joymonkey/logicengine/docs/img/Reactor-Zero-V6-overview.jpg

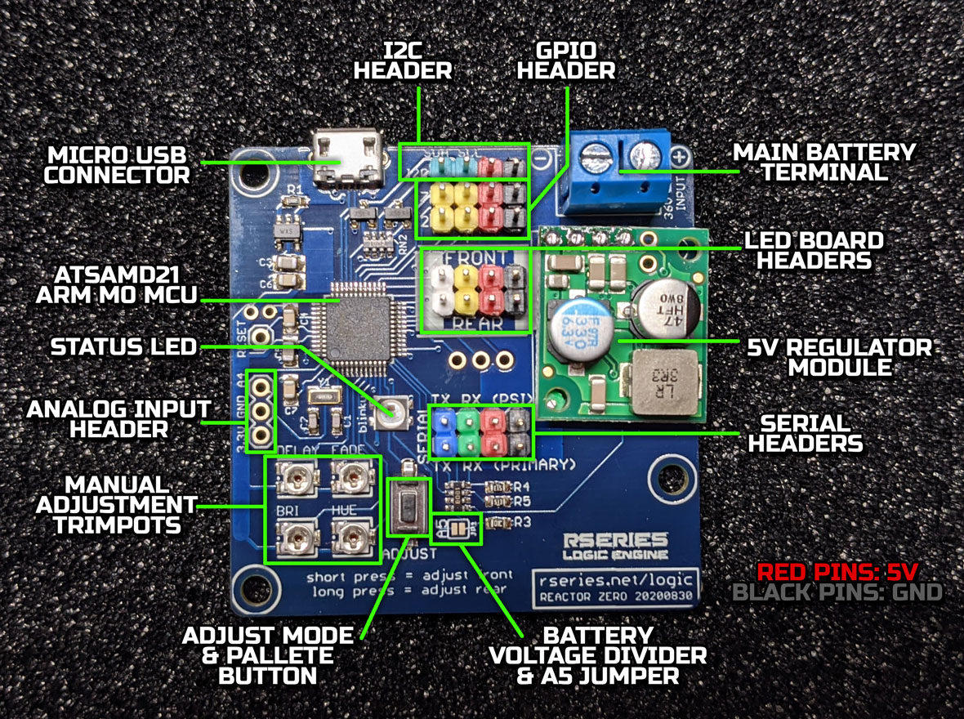
docs/img/Reactor-Zero-V6-overview.jpg
