joymonkey/logicengine/docs/img/Reactor-Zero-New-Pins.jpg

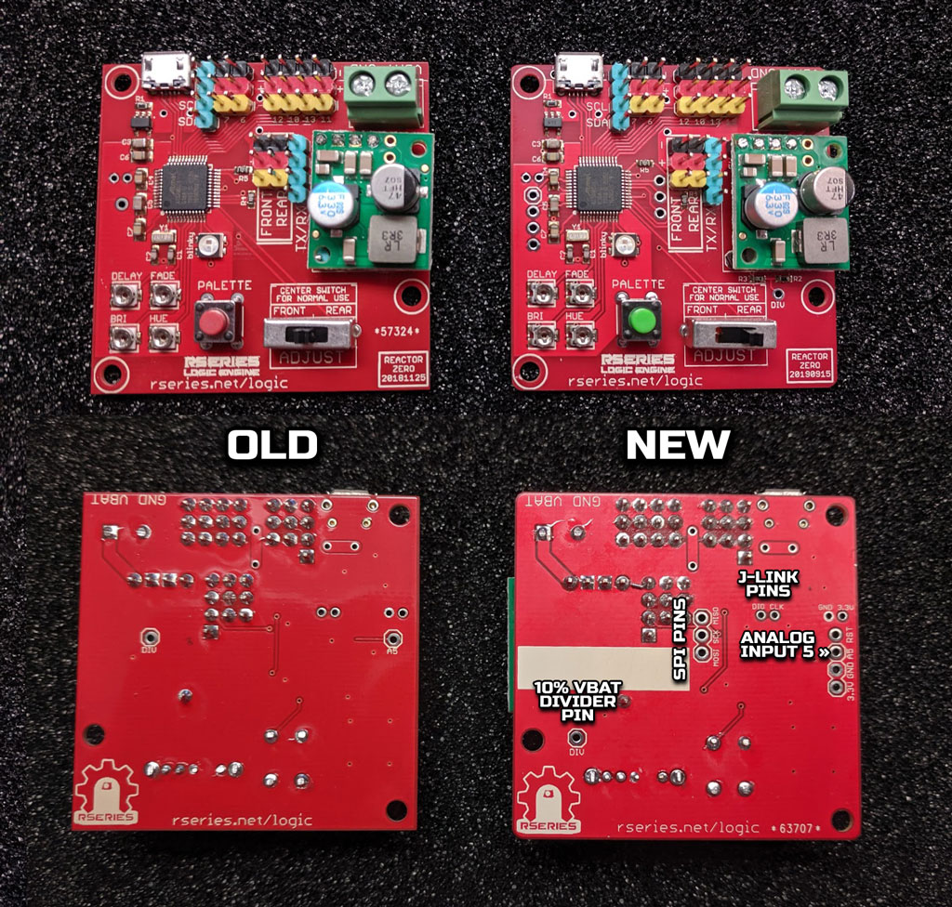
docs/img/Reactor-Zero-New-Pins.jpg
