joymonkey/logicengine/README.md

# logicengine
Info, Hardware Files and Arduino Sketches for the RSeries Logic Engine.

Assembly instructions and documentation can be found in the GitHub wiki here...
https://github.com/joymonkey/logicengine/wiki
