joymonkey/logicengine/docs/img/2016front1.jpg

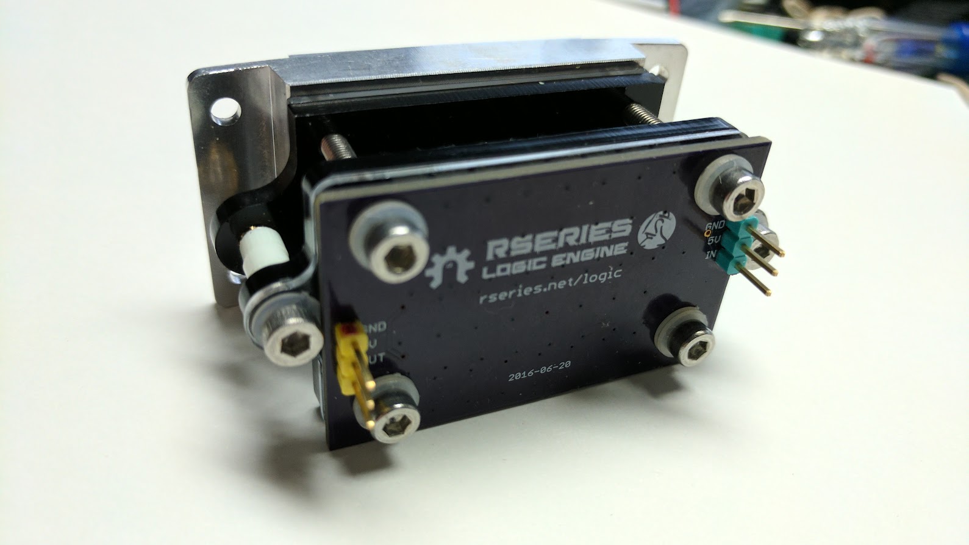
docs/img/2016front1.jpg
