joymonkey/logicengine/docs/img/2016front2.jpg

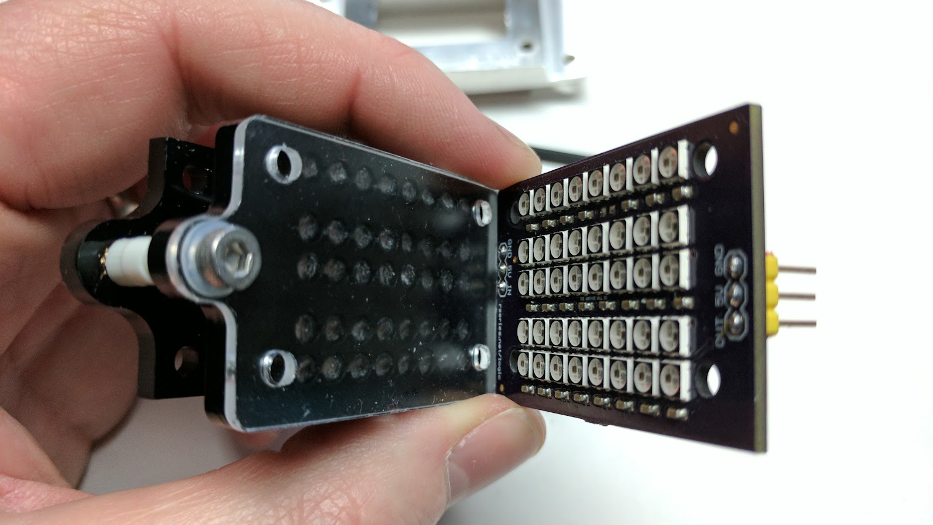
docs/img/2016front2.jpg
