joymonkey/logicengine/docs/img/avr_ftdi.png

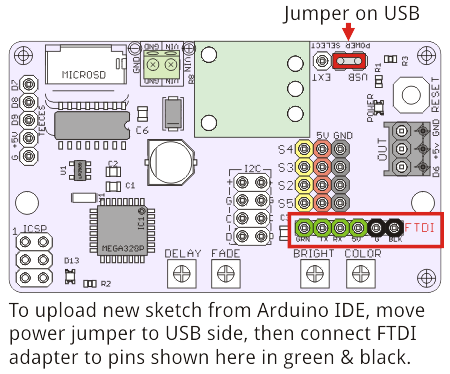
docs/img/avr_ftdi.png
