joymonkey/logicengine/docs/img/avr_microsd.png

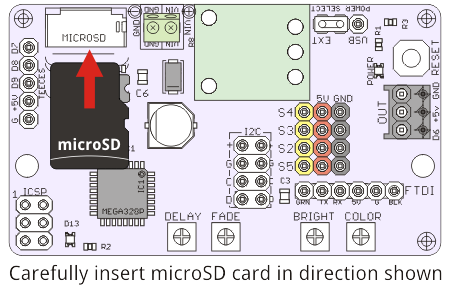
docs/img/avr_microsd.png
