joymonkey/logicengine/docs/img/avr_mode.png

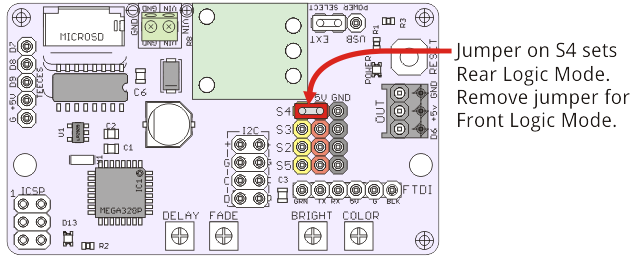
docs/img/avr_mode.png
