joymonkey/logicengine/docs/img/avr_powering.png

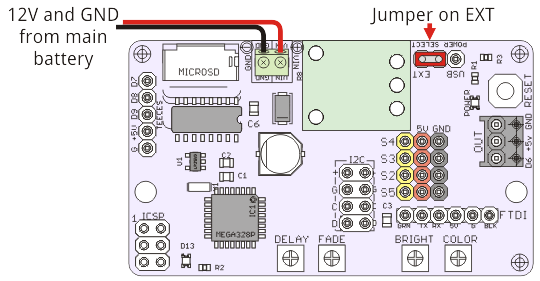
docs/img/avr_powering.png
