joymonkey/logicengine/docs/img/avr_speed.png

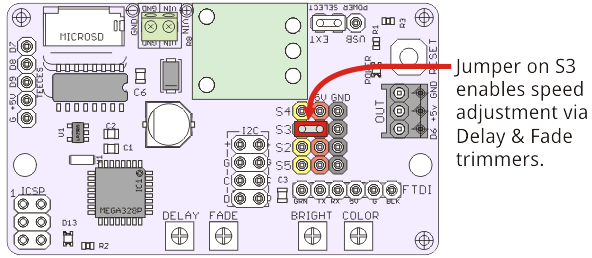
docs/img/avr_speed.png
