joymonkey/logicengine/docs/img/avr_to_teeces_psi.png

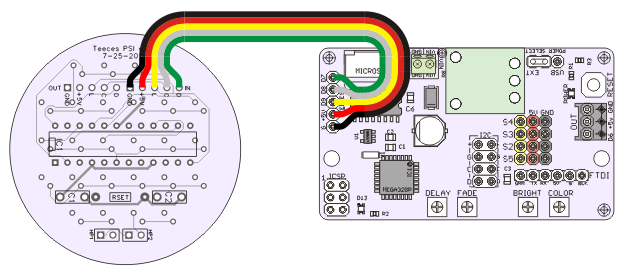
docs/img/avr_to_teeces_psi.png
