joymonkey/logicengine/docs/img/Deathstar1.jpg

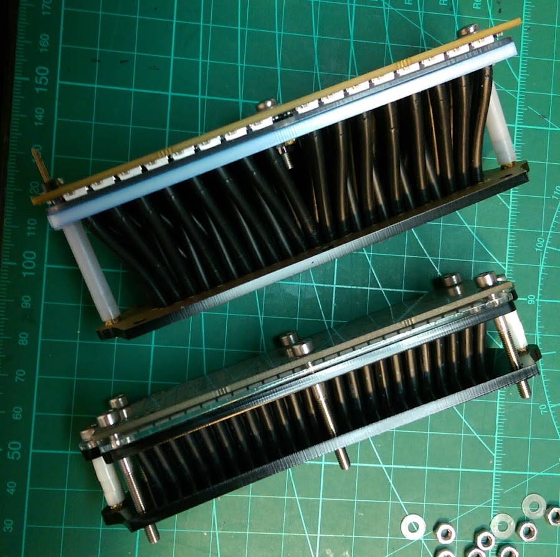
docs/img/Deathstar1.jpg
