joymonkey/logicengine/docs/img/Deathstar2.jpg

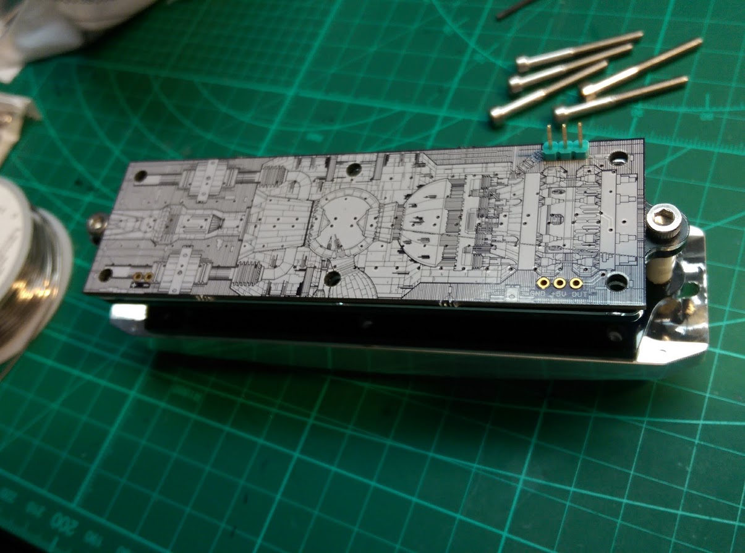
docs/img/Deathstar2.jpg
