joymonkey/logicengine/docs/img/Deathstar3.jpg

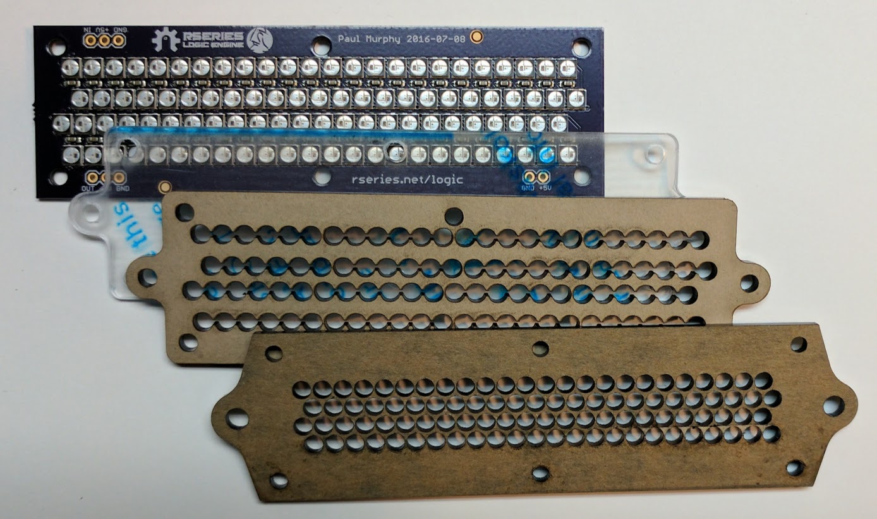
docs/img/Deathstar3.jpg
