joymonkey/logicengine/docs/img/front_bez_orientation1.jpg

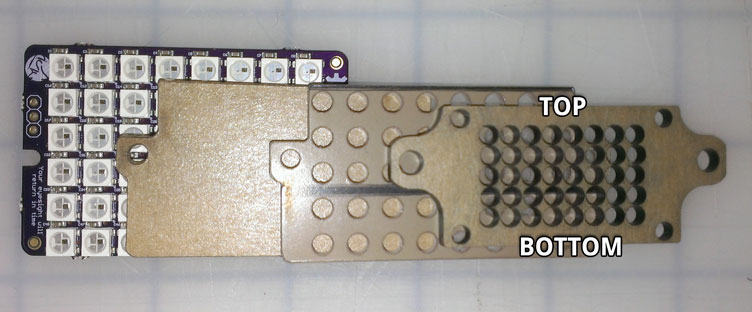
docs/img/front_bez_orientation1.jpg
