joymonkey/logicengine/docs/img/front_bez_orientation2.jpg

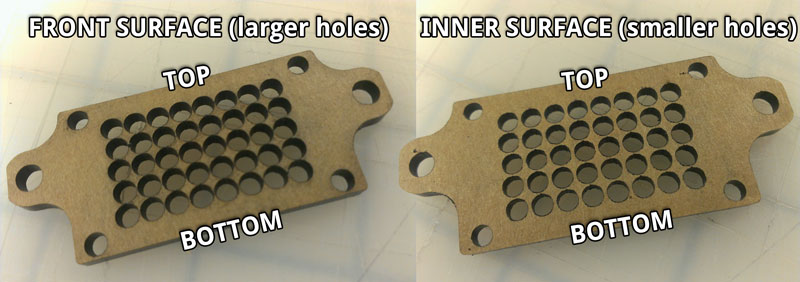
docs/img/front_bez_orientation2.jpg
