joymonkey/logicengine/docs/img/ImaharaRLD1.jpg

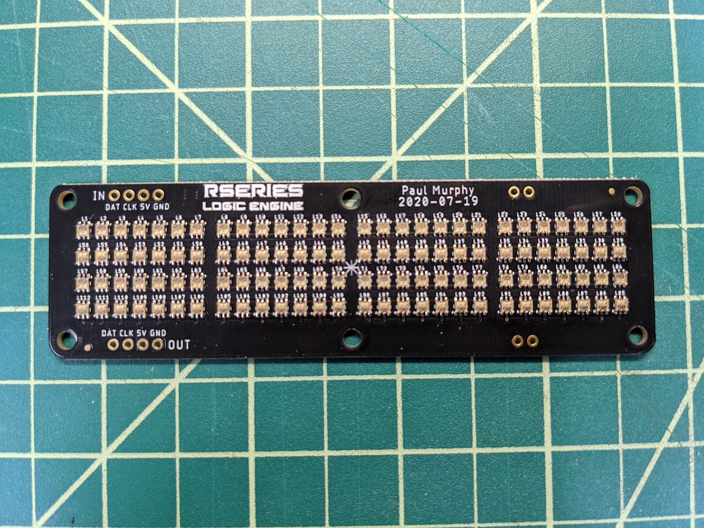
docs/img/ImaharaRLD1.jpg
