joymonkey/logicengine/docs/img/ImaharaRLD2.jpg

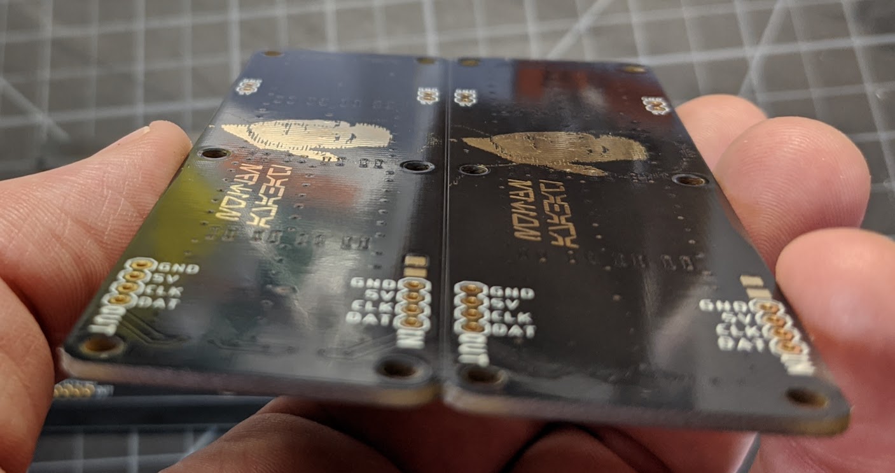
docs/img/ImaharaRLD2.jpg
