joymonkey/logicengine/docs/img/ImaharaRLD3.jpg

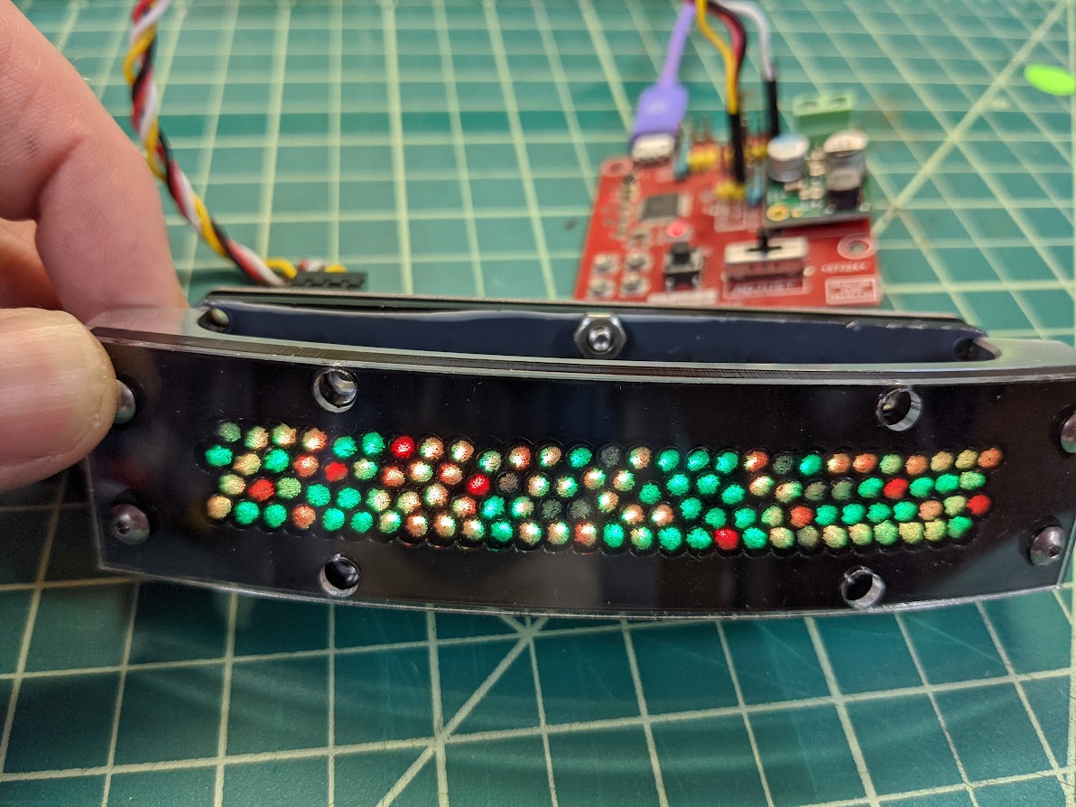
docs/img/ImaharaRLD3.jpg
