joymonkey/logicengine/docs/img/Logic-Engine-LED-board-front.png

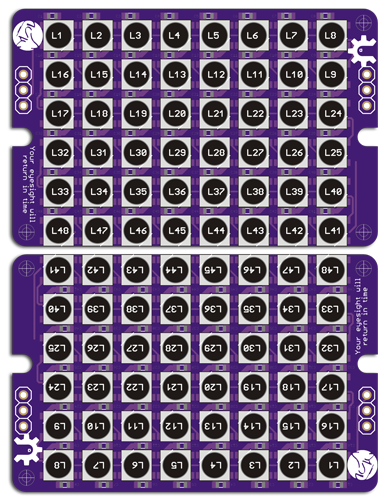
docs/img/Logic-Engine-LED-board-front.png
