joymonkey/logicengine/docs/img/Logic-Engine-LED-board-rear.png

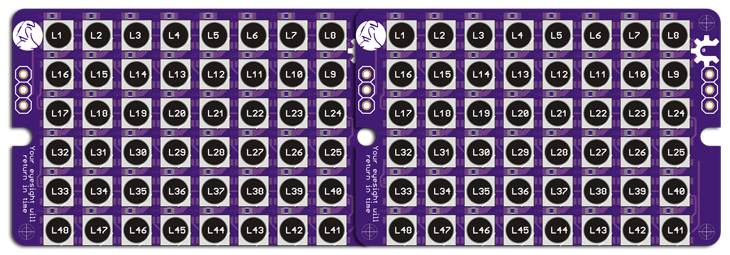
docs/img/Logic-Engine-LED-board-rear.png
