joymonkey/logicengine/docs/img/Logic_Engine_V6_cheat_sheet.png

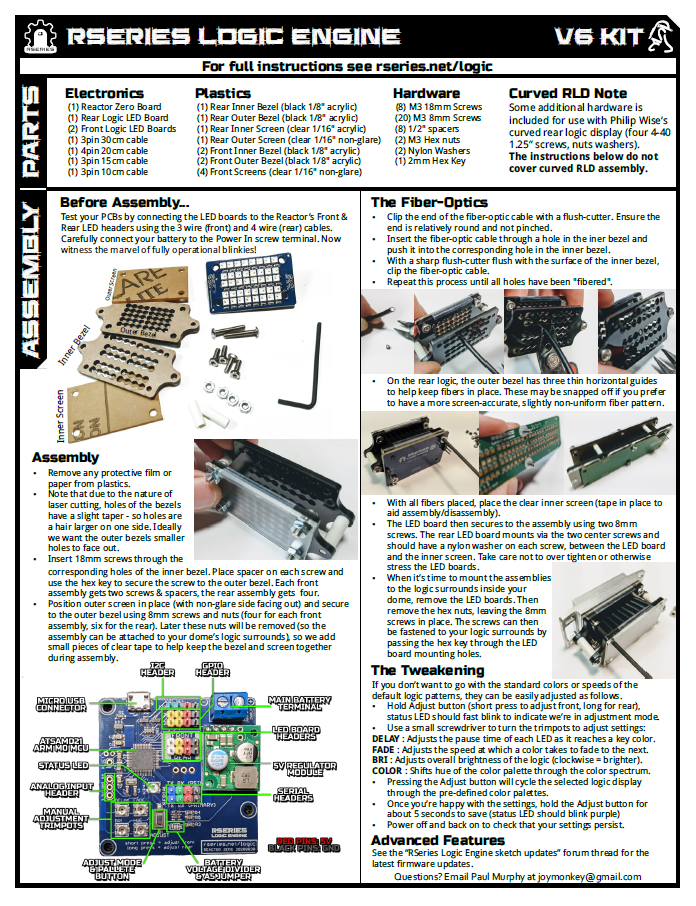
docs/img/Logic_Engine_V6_cheat_sheet.png
