joymonkey/logicengine/docs/img/LogicEngineAVRBoard.png

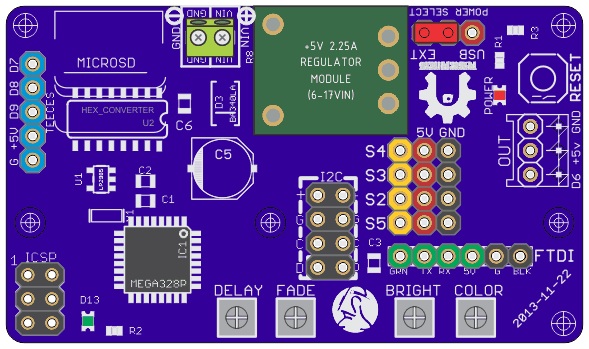
docs/img/LogicEngineAVRBoard.png
