joymonkey/logicengine/docs/img/LogicEngineDMX.jpg

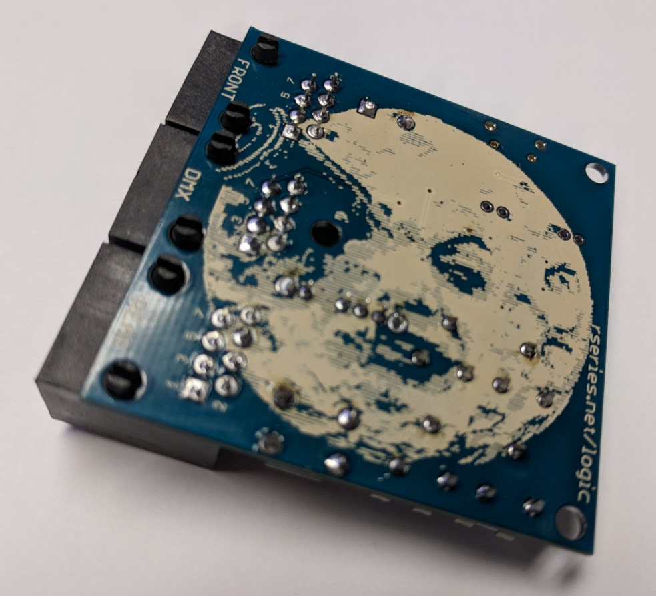
docs/img/LogicEngineDMX.jpg
