joymonkey/logicengine/docs/img/LogicEngineDMX_2.jpg

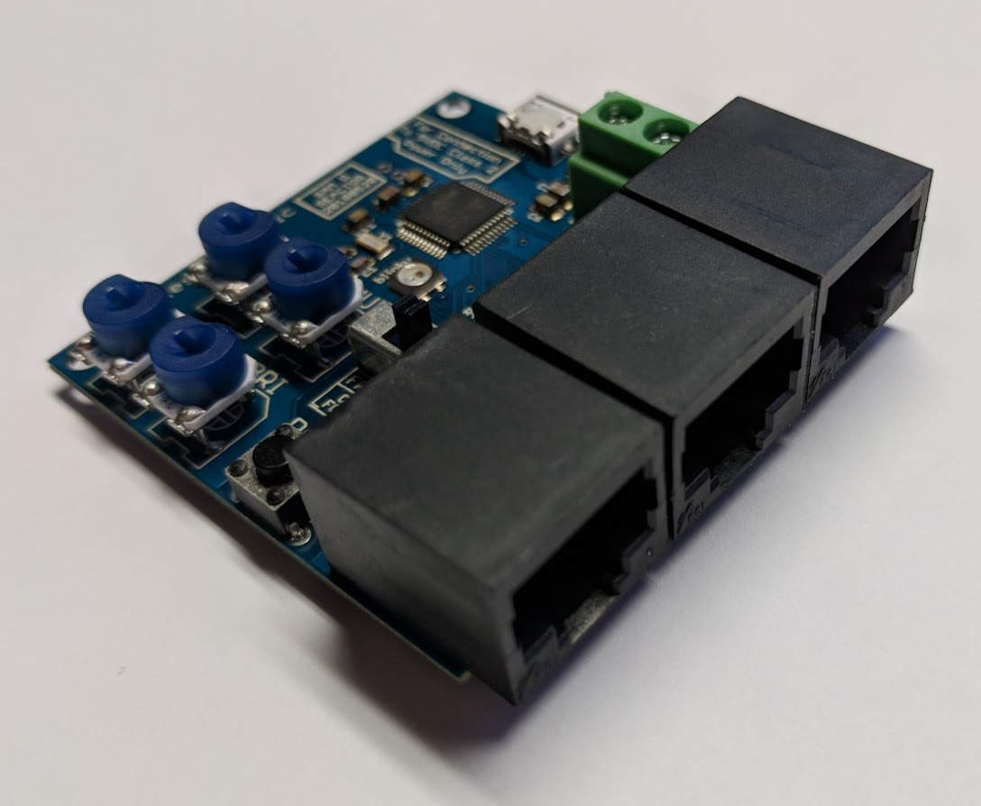
docs/img/LogicEngineDMX_2.jpg
