joymonkey/logicengine/docs/img/LogicEngineDMX_3.jpg

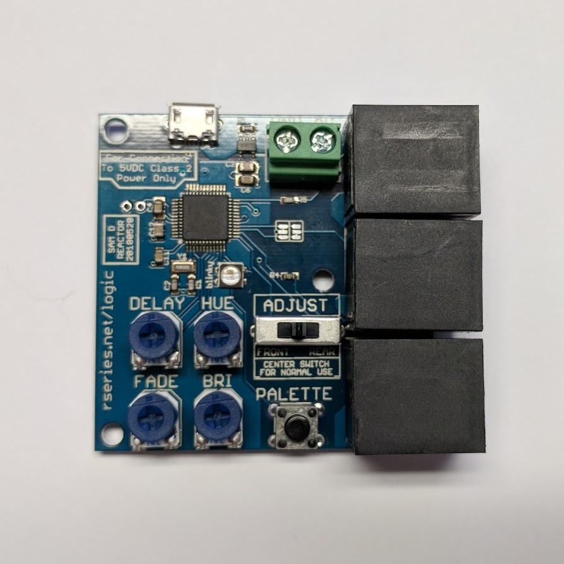
docs/img/LogicEngineDMX_3.jpg
