joymonkey/logicengine/docs/img/LogicEngineDMX_4.jpg

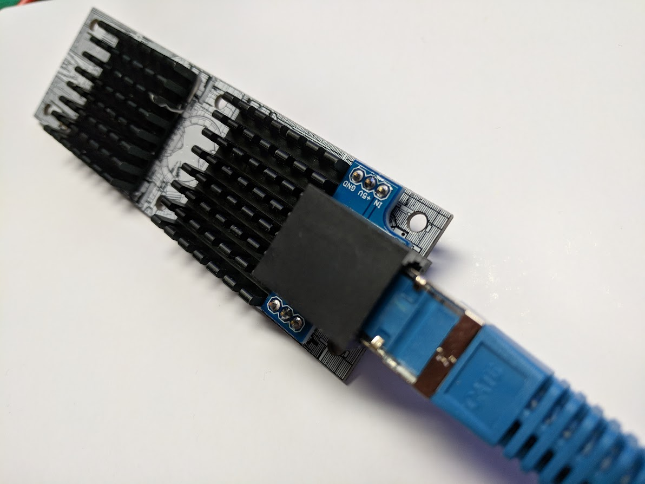
docs/img/LogicEngineDMX_4.jpg
