joymonkey/logicengine/docs/img/Reactor Zero to Teeces PSI Hookup.s.png

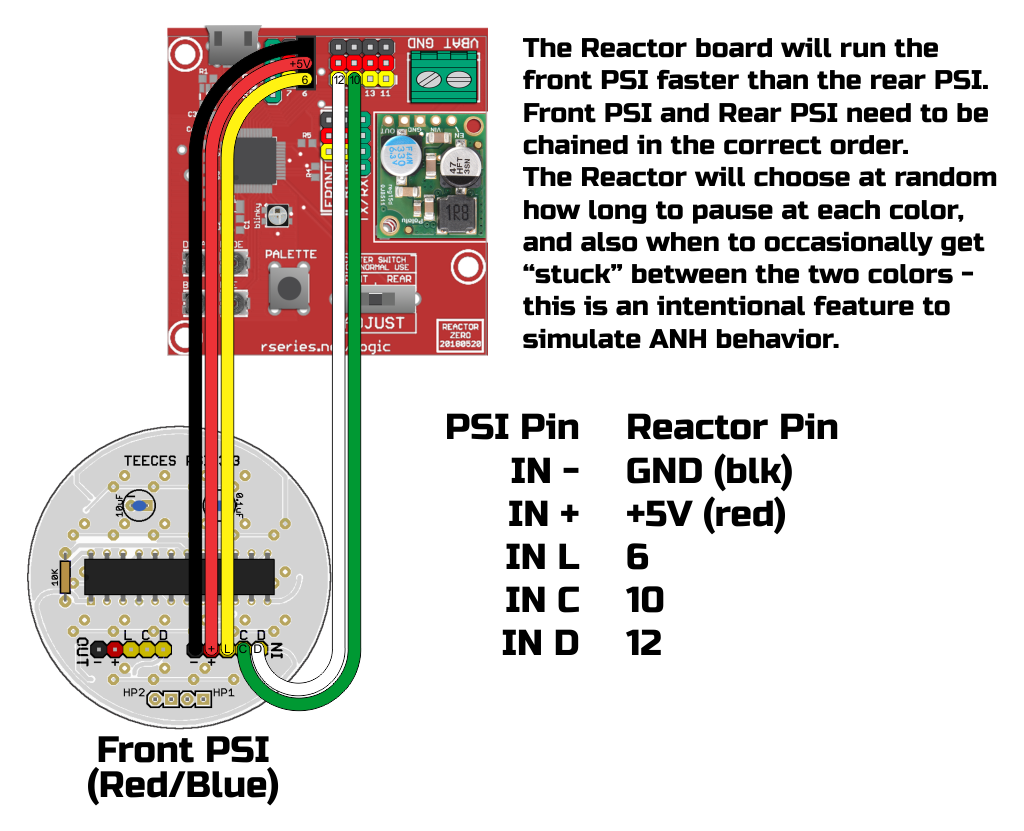
docs/img/Reactor Zero to Teeces PSI Hookup.s.png
