joymonkey/logicengine/docs/img/Reactor-Zero-20181125.jpg

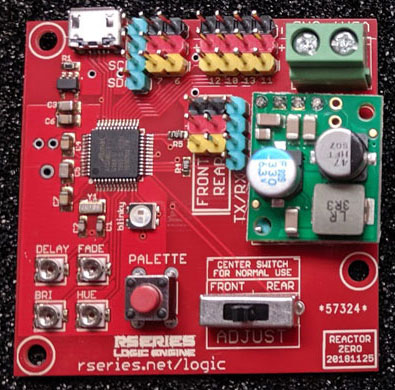
docs/img/Reactor-Zero-20181125.jpg
