joymonkey/logicengine/docs/img/Reactor-Zero-20190915.jpg

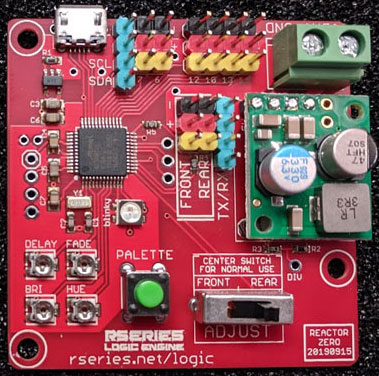
docs/img/Reactor-Zero-20190915.jpg
