joymonkey/logicengine/docs/img/Reactor-Zero-20200830.jpg

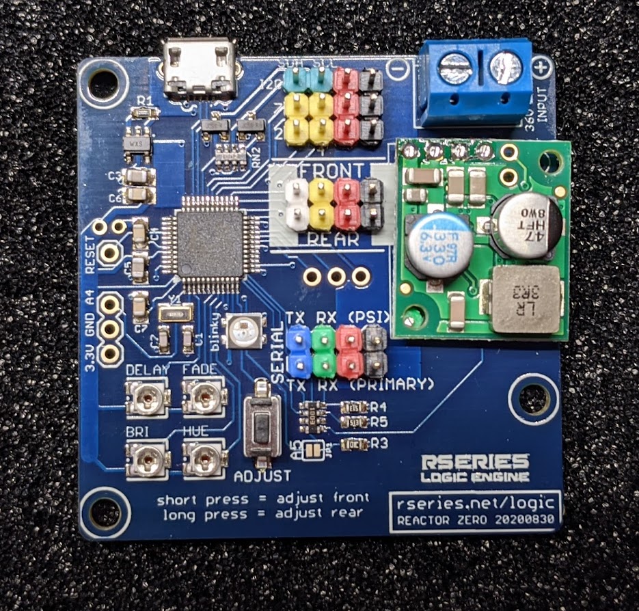
docs/img/Reactor-Zero-20200830.jpg
