joymonkey/logicengine/docs/img/Reactor-Zero-SerialAdapter.jpg

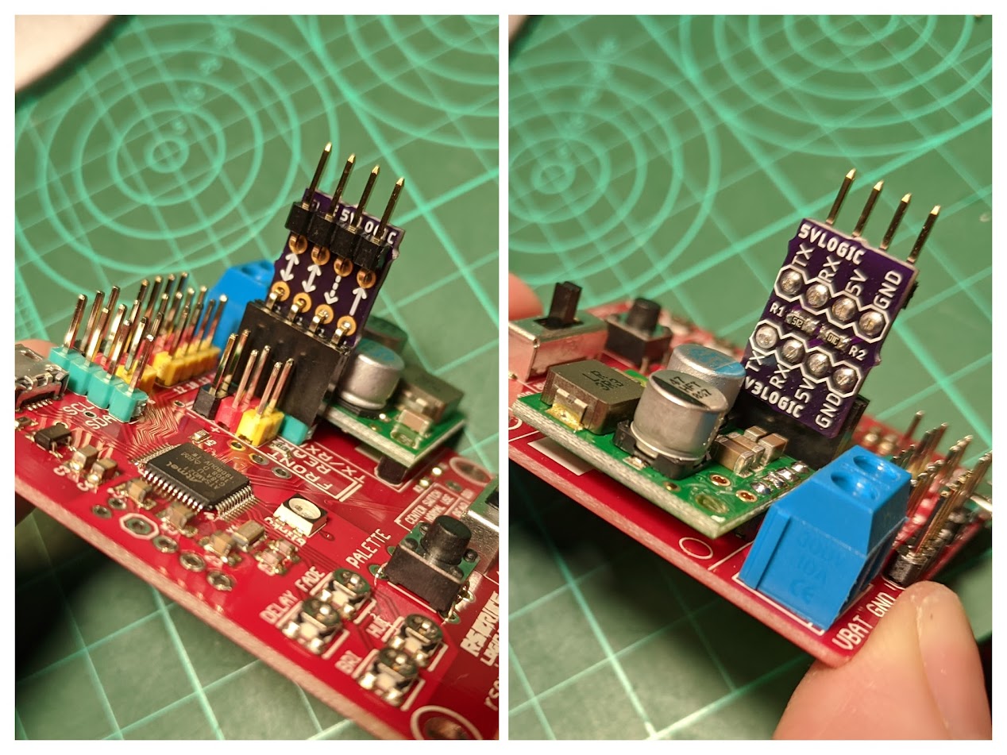
docs/img/Reactor-Zero-SerialAdapter.jpg
