joymonkey/logicengine/docs/img/ReactorZero-board-only.png

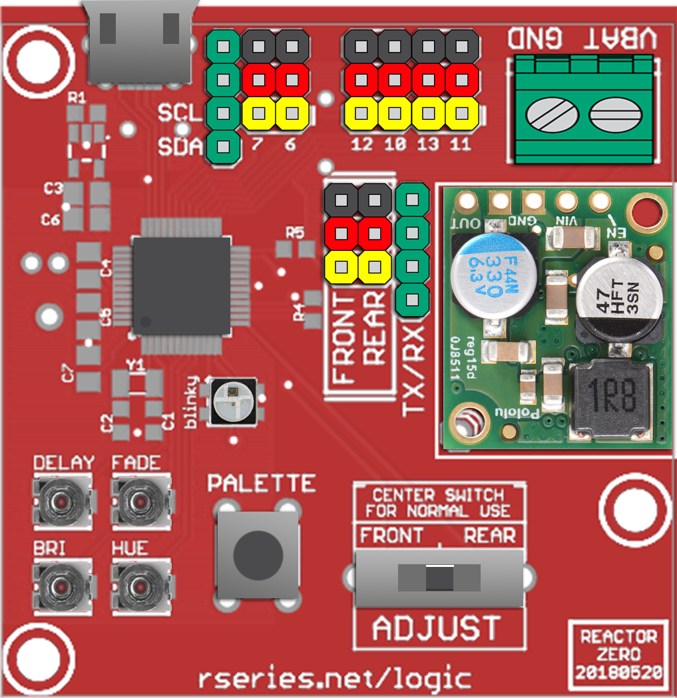
docs/img/ReactorZero-board-only.png
