joymonkey/logicengine/docs/img/rld-pattern-numbered.png

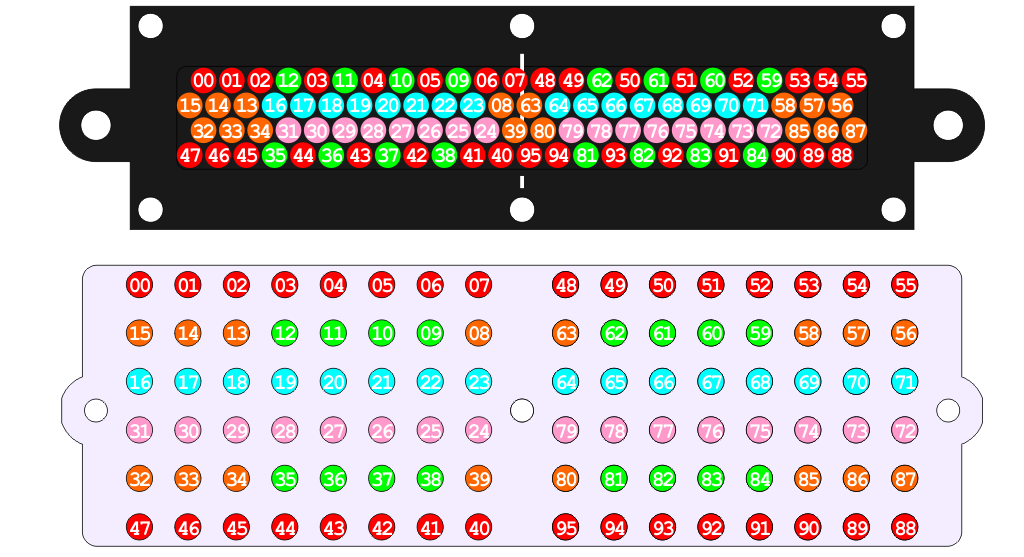
docs/img/rld-pattern-numbered.png
