joymonkey/logicengine/docs/img/TeensyReactor_full.jpg

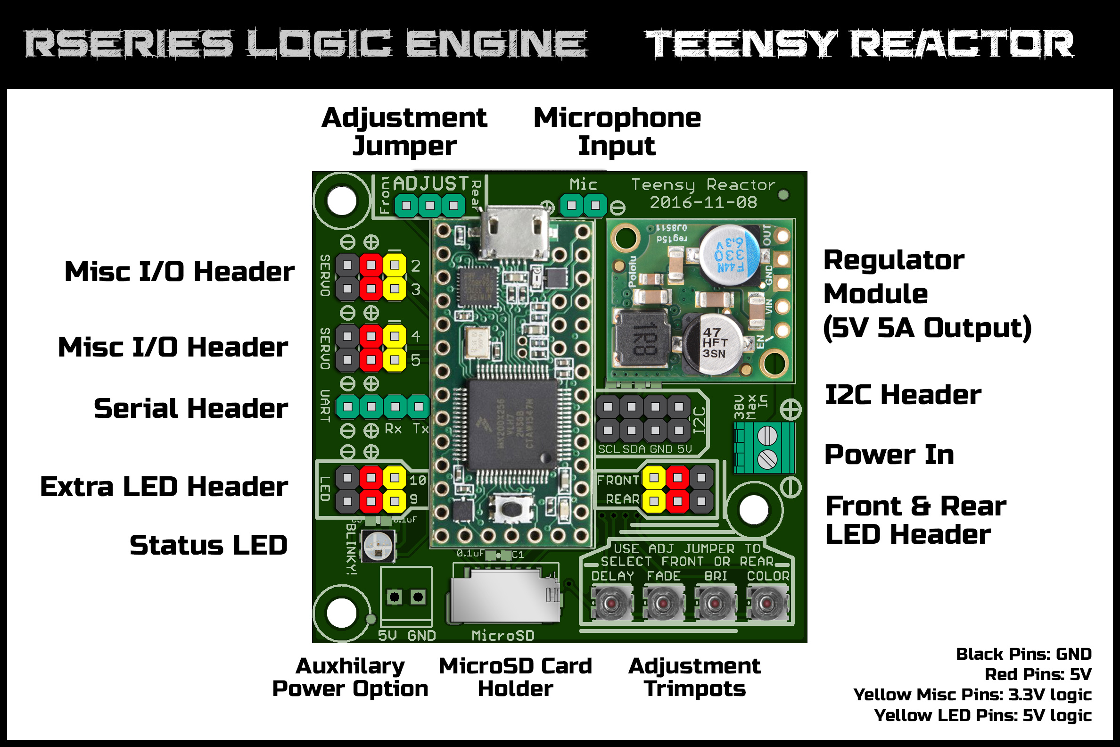
docs/img/TeensyReactor_full.jpg
