joymonkey/logicengine/docs/img/TeensyReactorPrototype.jpg

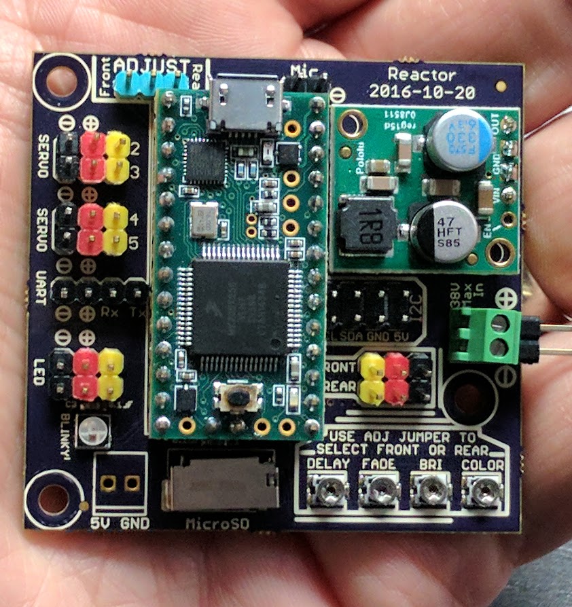
docs/img/TeensyReactorPrototype.jpg
