joymonkey/logicengine/docs/img/uploadZeroFW/3-select_Board.png

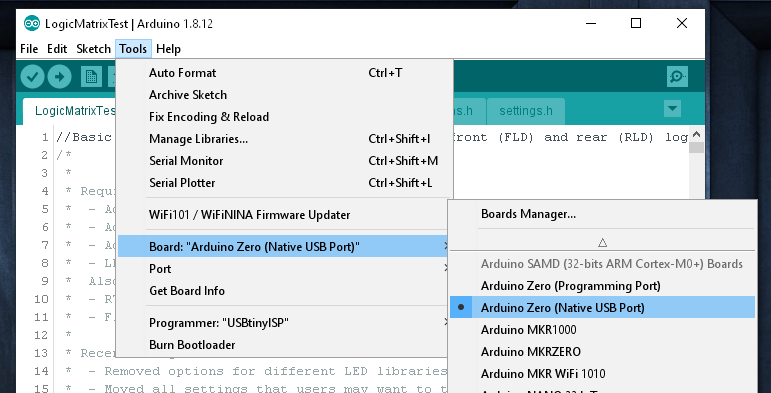
docs/img/uploadZeroFW/3-select_Board.png
