joymonkey/logicengine/docs/img/uploadZeroFW/4-select_Port.png

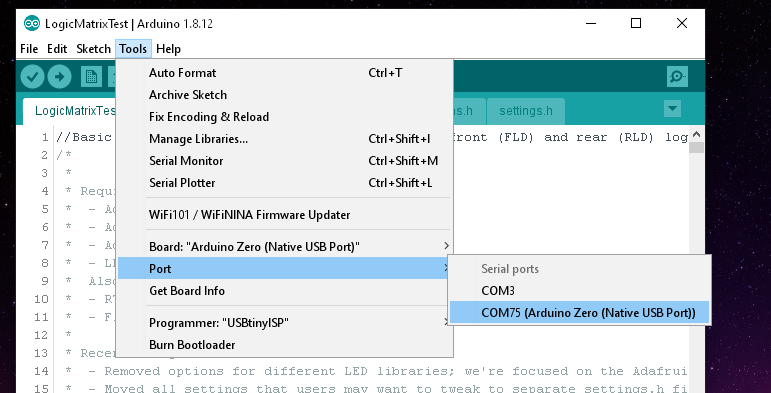
docs/img/uploadZeroFW/4-select_Port.png
