joymonkey/logicengine/docs/img/uploadZeroFW/5-upload_Success.png

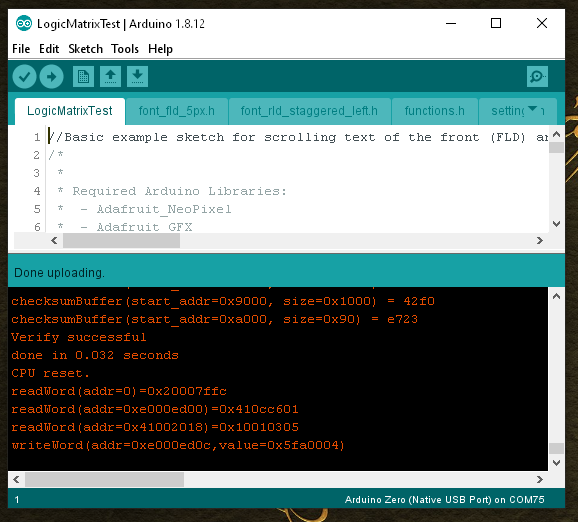
docs/img/uploadZeroFW/5-upload_Success.png
