joymonkey/logicengine/docs/img/WREACTOR32-PCB.png

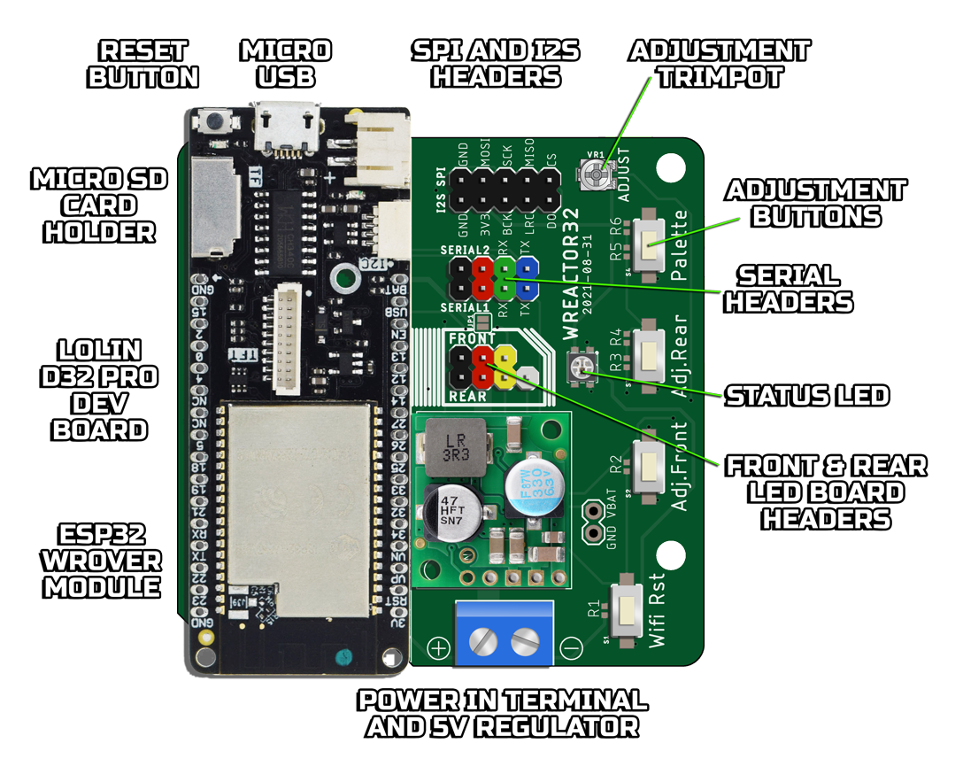
docs/img/WREACTOR32-PCB.png
