joymonkey/logicengine/docs/img/wreactor32/1-home.png

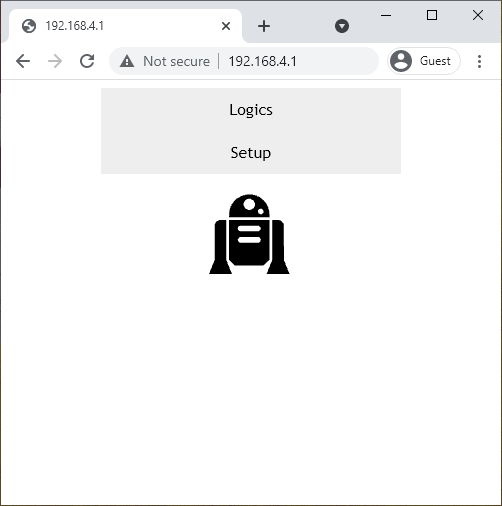
docs/img/wreactor32/1-home.png
