joymonkey/logicengine/docs/img/wreactor32/1-home_th.png

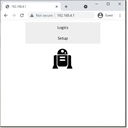
docs/img/wreactor32/1-home_th.png
