joymonkey/logicengine/docs/img/wreactor32/2-logics.png

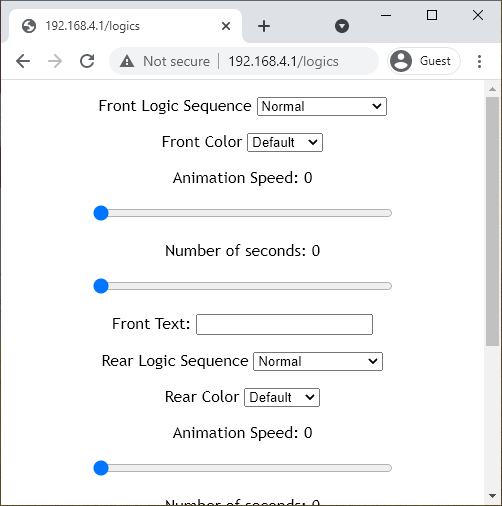
docs/img/wreactor32/2-logics.png
