joymonkey/logicengine/docs/img/wreactor32/4-firmware.png

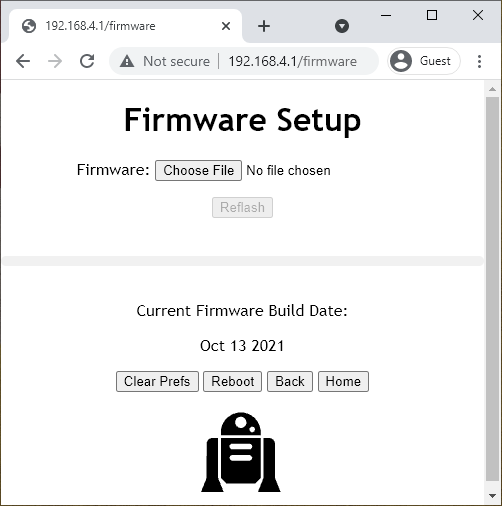
docs/img/wreactor32/4-firmware.png
