joymonkey/logicengine/docs/img/wreactor32/5-marcduino.png

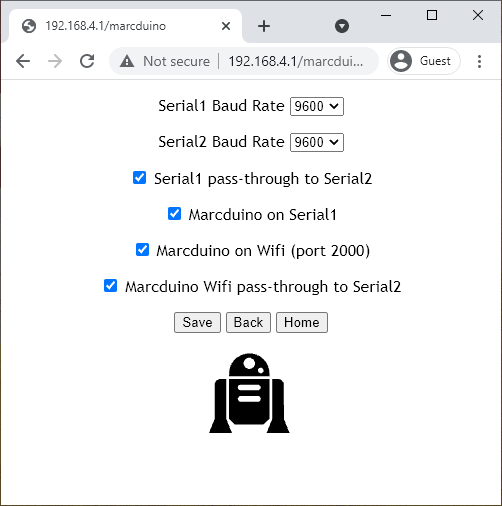
docs/img/wreactor32/5-marcduino.png
