joymonkey/logicengine/docs/img/wreactor32/5-marcduino_th.png

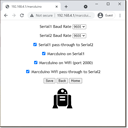
docs/img/wreactor32/5-marcduino_th.png
