joymonkey/logicengine/docs/img/wreactor32/6-wifi.png

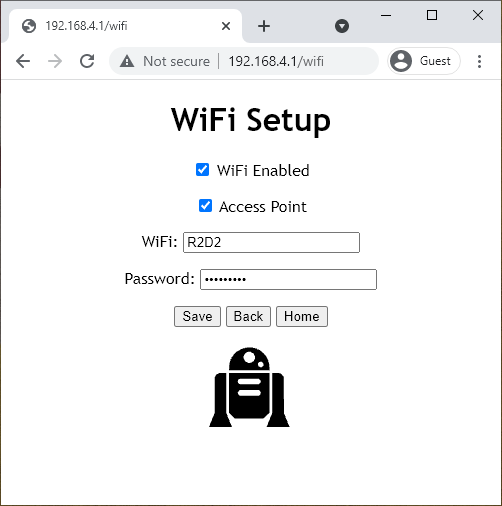
docs/img/wreactor32/6-wifi.png
