joymonkey/logicengine/docs/img/WReactor32_2024.jpg

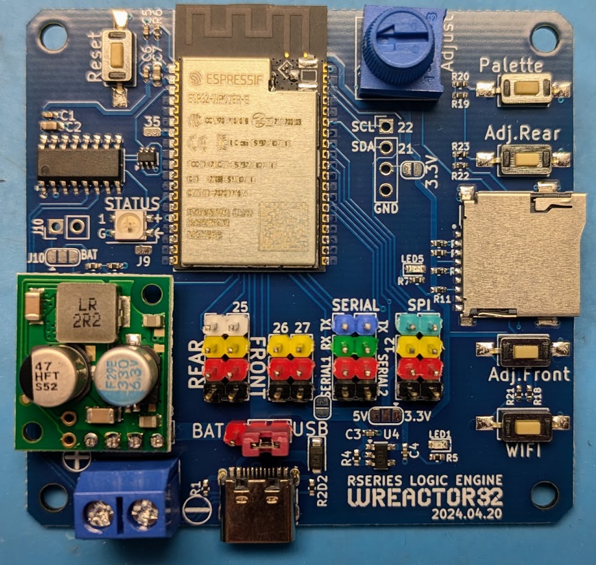
docs/img/WReactor32_2024.jpg
