joymonkey/logicengine/wreactor32_rework/rework1.jpg

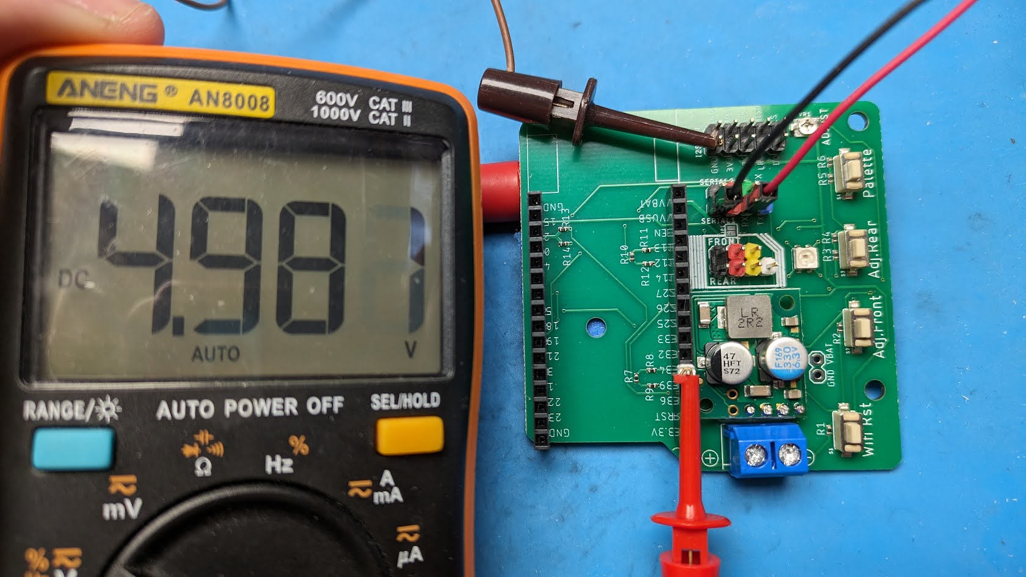
wreactor32_rework/rework1.jpg
