joymonkey/logicengine/wreactor32_rework/rework2.jpg

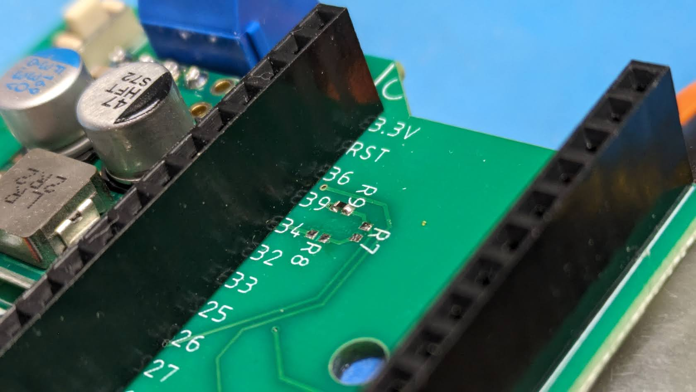
wreactor32_rework/rework2.jpg
