joymonkey/logicengine/wreactor32_rework/rework3.jpg

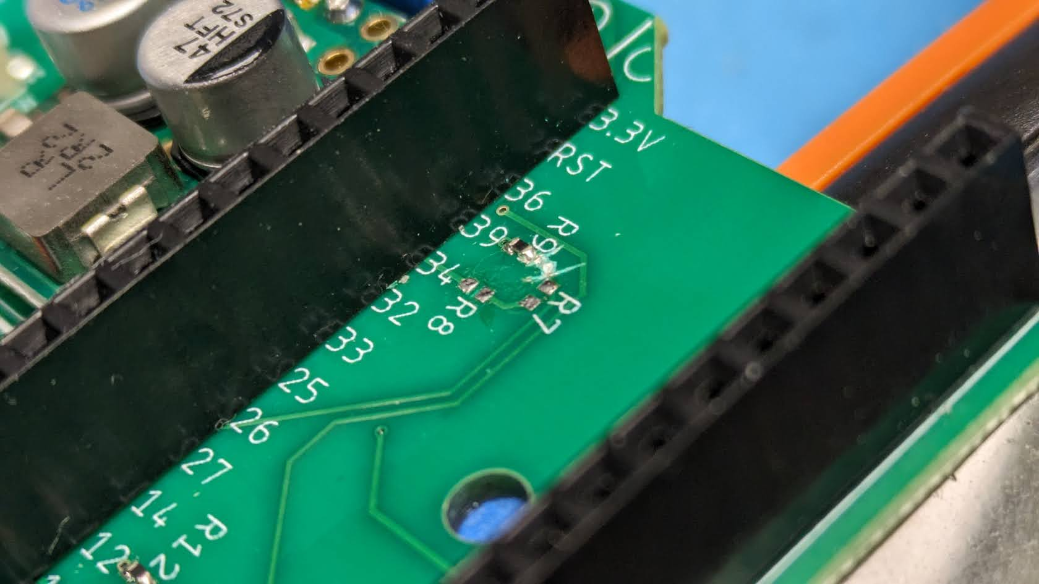
wreactor32_rework/rework3.jpg
