joymonkey/logicengine/wreactor32_rework/rework4.jpg

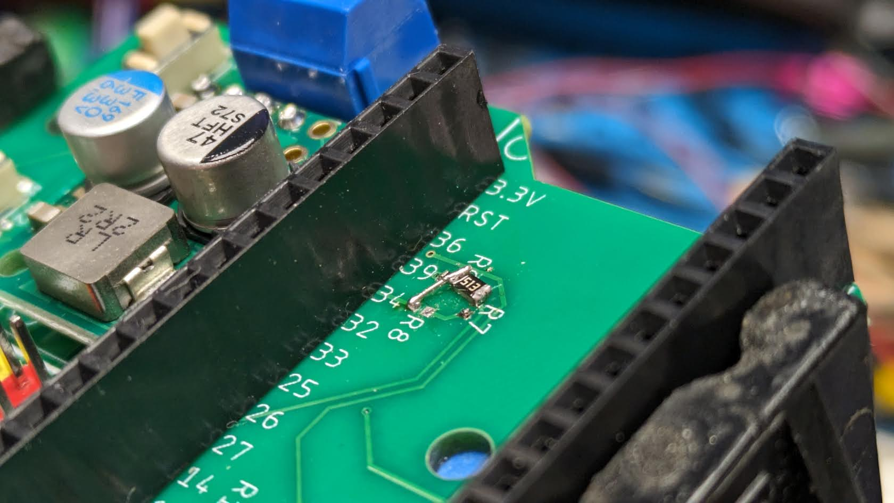
wreactor32_rework/rework4.jpg
