joymonkey/logicengine/wreactor32_rework/rework5.jpg

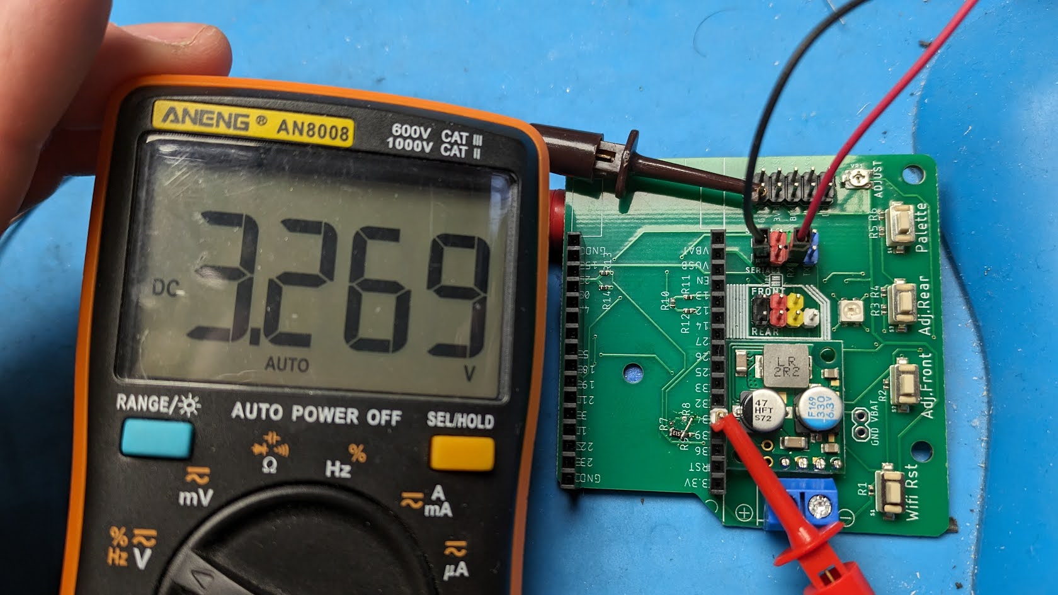
wreactor32_rework/rework5.jpg
