joymonkey/logicengine/docs/img/Logic_Engine_Parts.png

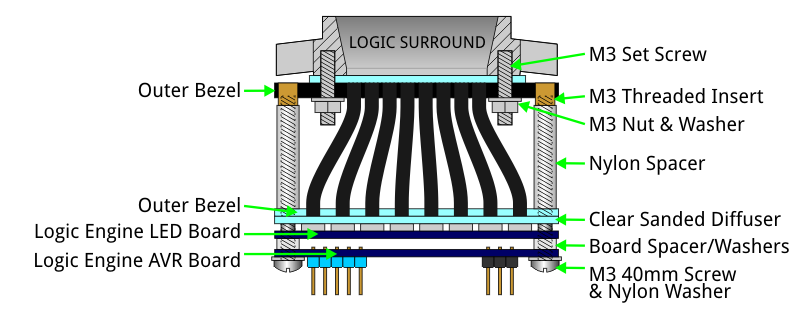
docs/img/Logic_Engine_Parts.png
