joymonkey/logicengine/Hardware Designs/Reactor to RLD mounty thing.stl

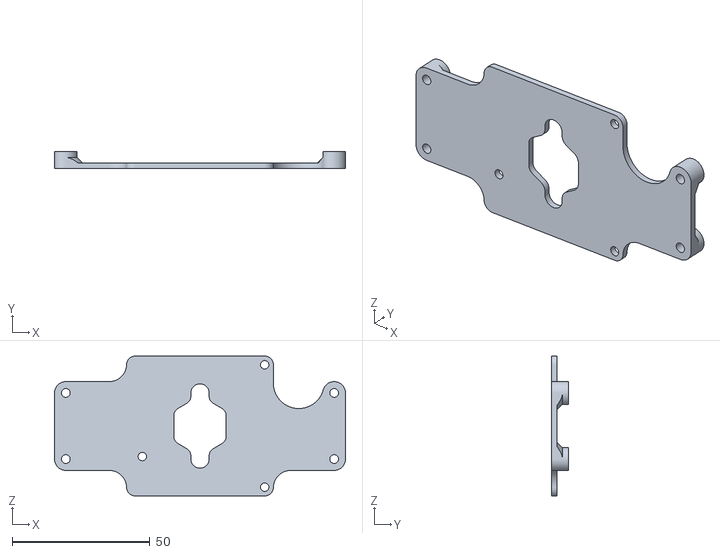
[picture p54: CAD file, 2019-12-30]
Hardware Designs/Reactor to RLD mounty thing.stl
105.7 x 6.35 x 50.8
