joymonkey/logicengine/docs/img/uploadZeroFW/1-install_Boards.png

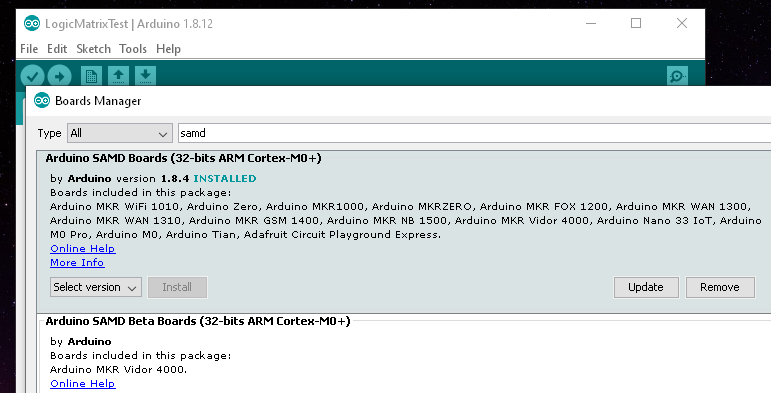
docs/img/uploadZeroFW/1-install_Boards.png
