joymonkey/logicengine/docs/img/uploadZeroFW/2-install_Libraries.png

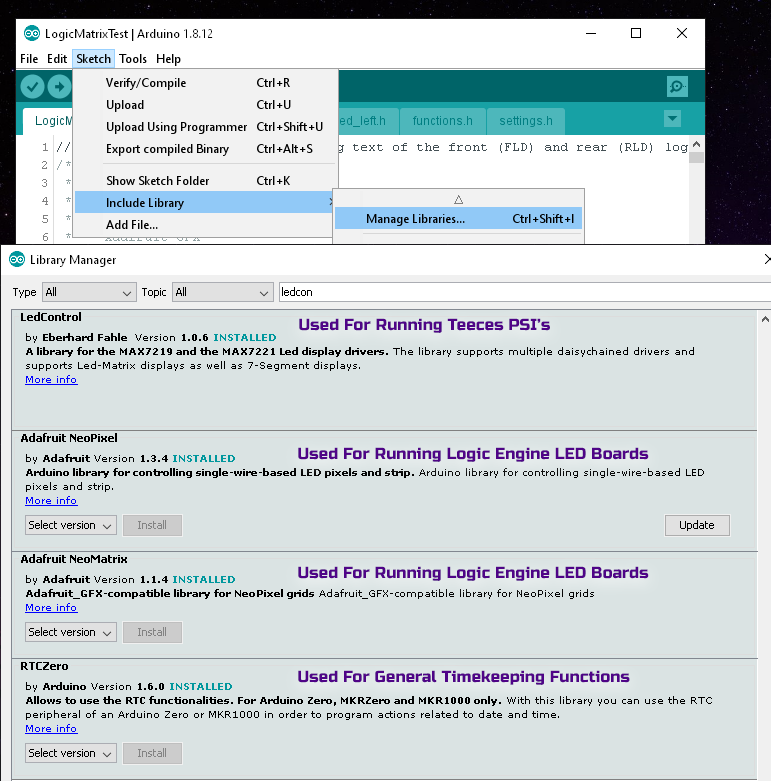
docs/img/uploadZeroFW/2-install_Libraries.png
