joymonkey/logicengine/docs/img/wreactor32/3-setup.png

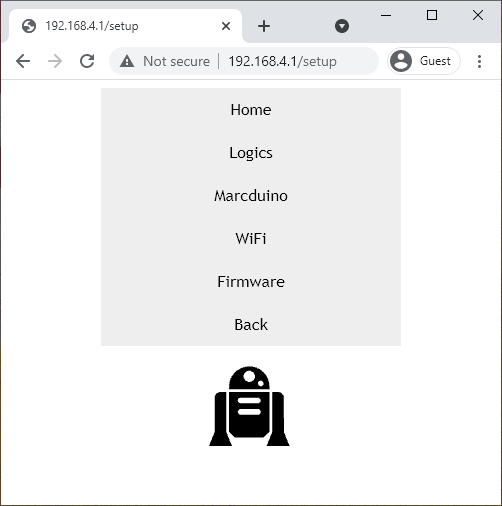
docs/img/wreactor32/3-setup.png
