joymonkey/logicengine/docs/img/wreactor32/3-setup_th.png

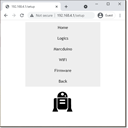
docs/img/wreactor32/3-setup_th.png
