joymonkey/logicengine/docs/img/wreactor32/7-setuplogics.png

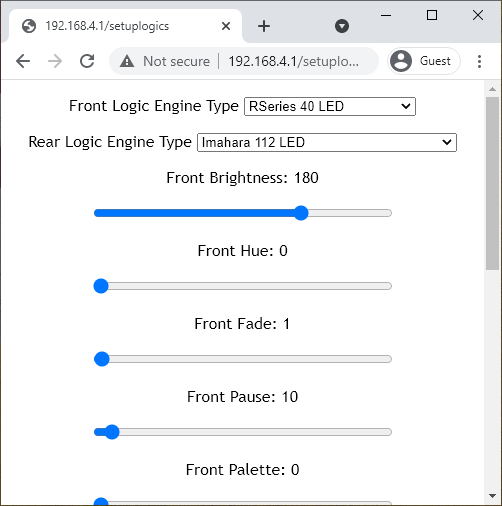
docs/img/wreactor32/7-setuplogics.png
