joymonkey/logicengine/Hardware Designs/Reactor_Mount.pdf

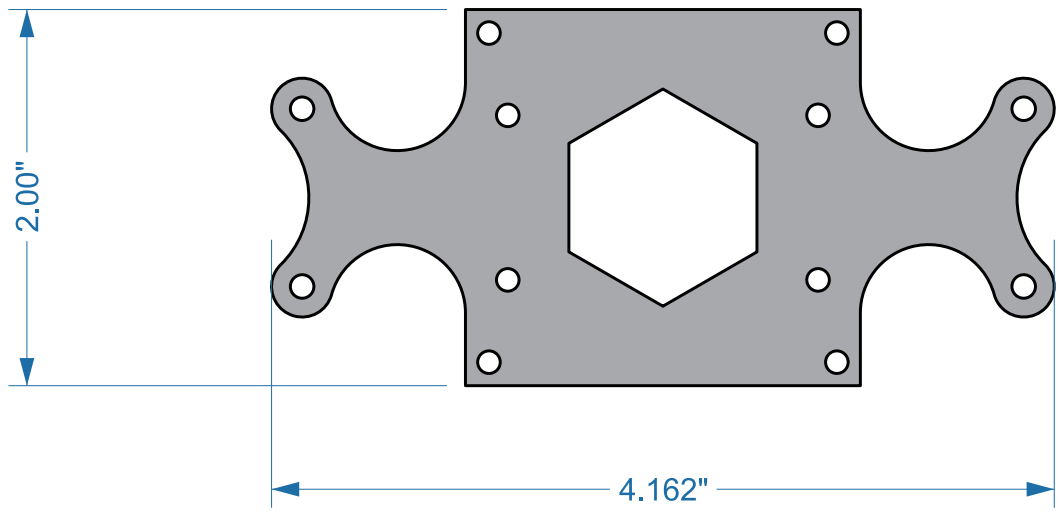
[picture p60: page 1]
