joymonkey/logicengine/Hardware Designs/Teeces PSI.brd

## EAGLE design Hardware Designs/Teeces PSI.brd (2020-03-06)

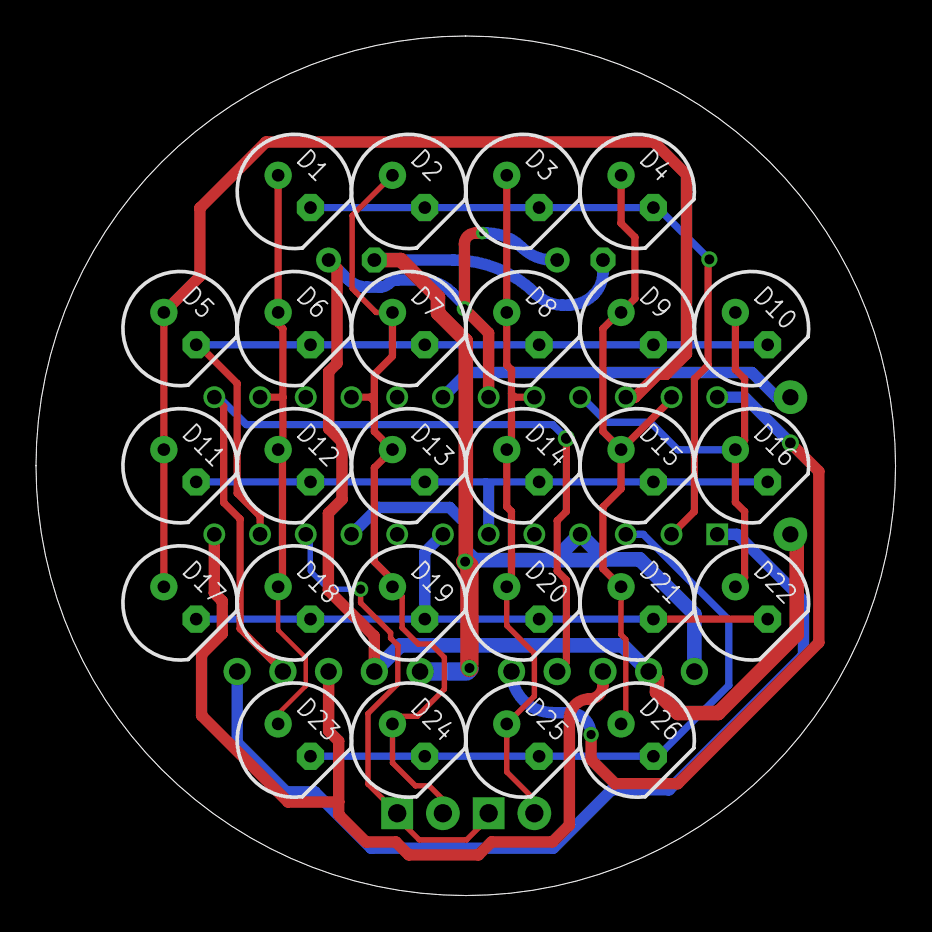
[picture p61: board Teeces PSI.brd from above]

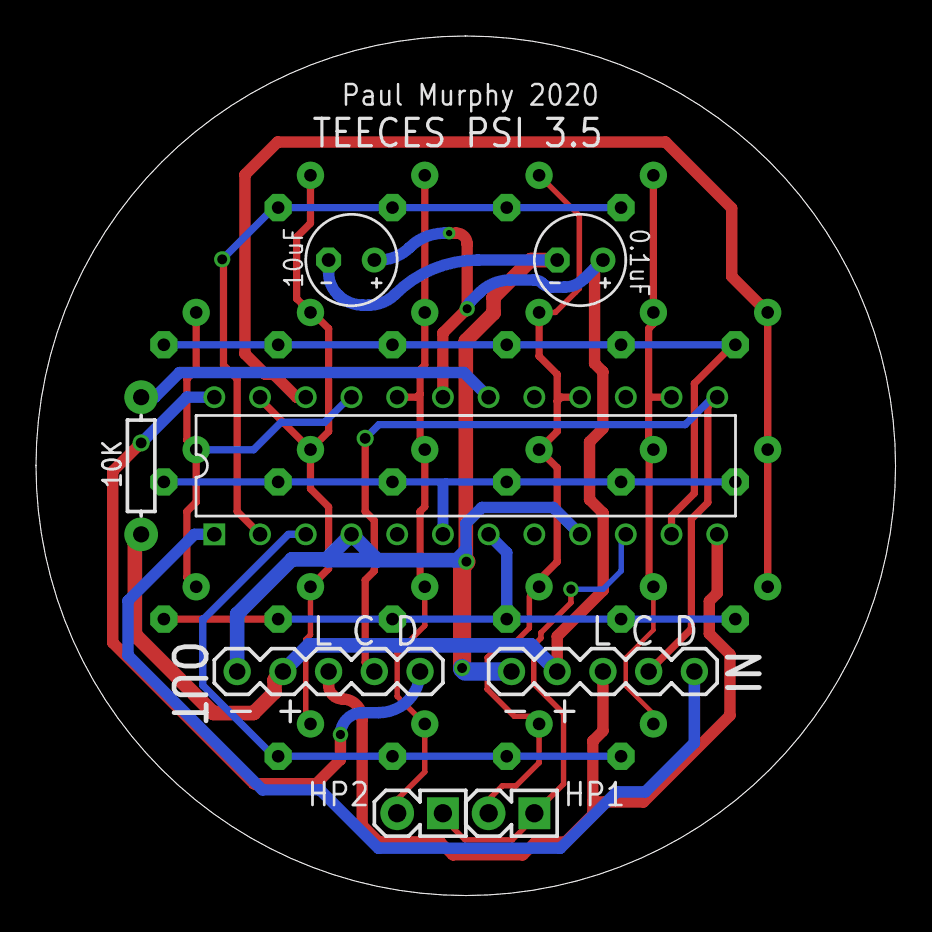
[picture p62: board Teeces PSI.brd from below]

Board: 2 copper layers, 47.8 x 47.8 mm, 34 parts (8 on the bottom side), 19 nets.

Parts:
C5: 10uF; E2,5-5
C6: 0.1uF; E2,5-5
D1, D2, D3, D4, D5, D6, D7, D8, D9, D10, D11, D12, D13, D14, D15, D16, D17, D18, D19, D20, D21, D22, D23, D24, D25, D26: LED5MM_SLIM
HP1, HP2: 1X02-SQ
IC2: MAX7219CNG; DIP24-3
IN: 1X05
OUT: 1X05
R2: 10K; AXIAL-0.3

Connections:
+5V: C5.+, C6.+, IC2.19, IN.2, OUT.2, R2.P$2
CLK: IC2.13, IN.4, OUT.4
DIG0: D1.K, D2.K, D3.K, D4.K, IC2.2
DIG1: D5.K, D6.K, D7.K, D8.K, D9.K, D10.K, IC2.11
DIG2: D11.K, D12.K, D13.K, D14.K, D15.K, D16.K, IC2.6
DIG3: D17.K, D18.K, D19.K, D20.K, D21.K, D22.K, IC2.7
DIG4: D23.K, D24.K, D25.K, D26.K, IC2.3
DIG5: HP1.1, HP2.1, IC2.10
DIN: IC2.1, IN.5
DOUT: IC2.24, OUT.5
GND: C5.-, C6.-, IC2.4, IC2.9, IN.1, OUT.1
LOAD: IC2.12, IN.3, OUT.3
unnamed: IC2.18, R2.P$1
SEGA: D1.A, D6.A, D12.A, D18.A, D23.A, IC2.14
SEGB: D2.A, D7.A, D13.A, D19.A, D24.A, HP1.2, IC2.16
SEGC: D3.A, D8.A, D14.A, D20.A, D25.A, HP2.2, IC2.20
SEGD: D4.A, D9.A, D15.A, D21.A, D26.A, IC2.23
SEGDP: D5.A, D11.A, D17.A, IC2.22
SEGE: D10.A, D16.A, D22.A, IC2.21
