joymonkey/logicengine/Hardware Designs/Reactor_Zero.brd

## EAGLE design Hardware Designs/Reactor_Zero.brd (2019-10-20)

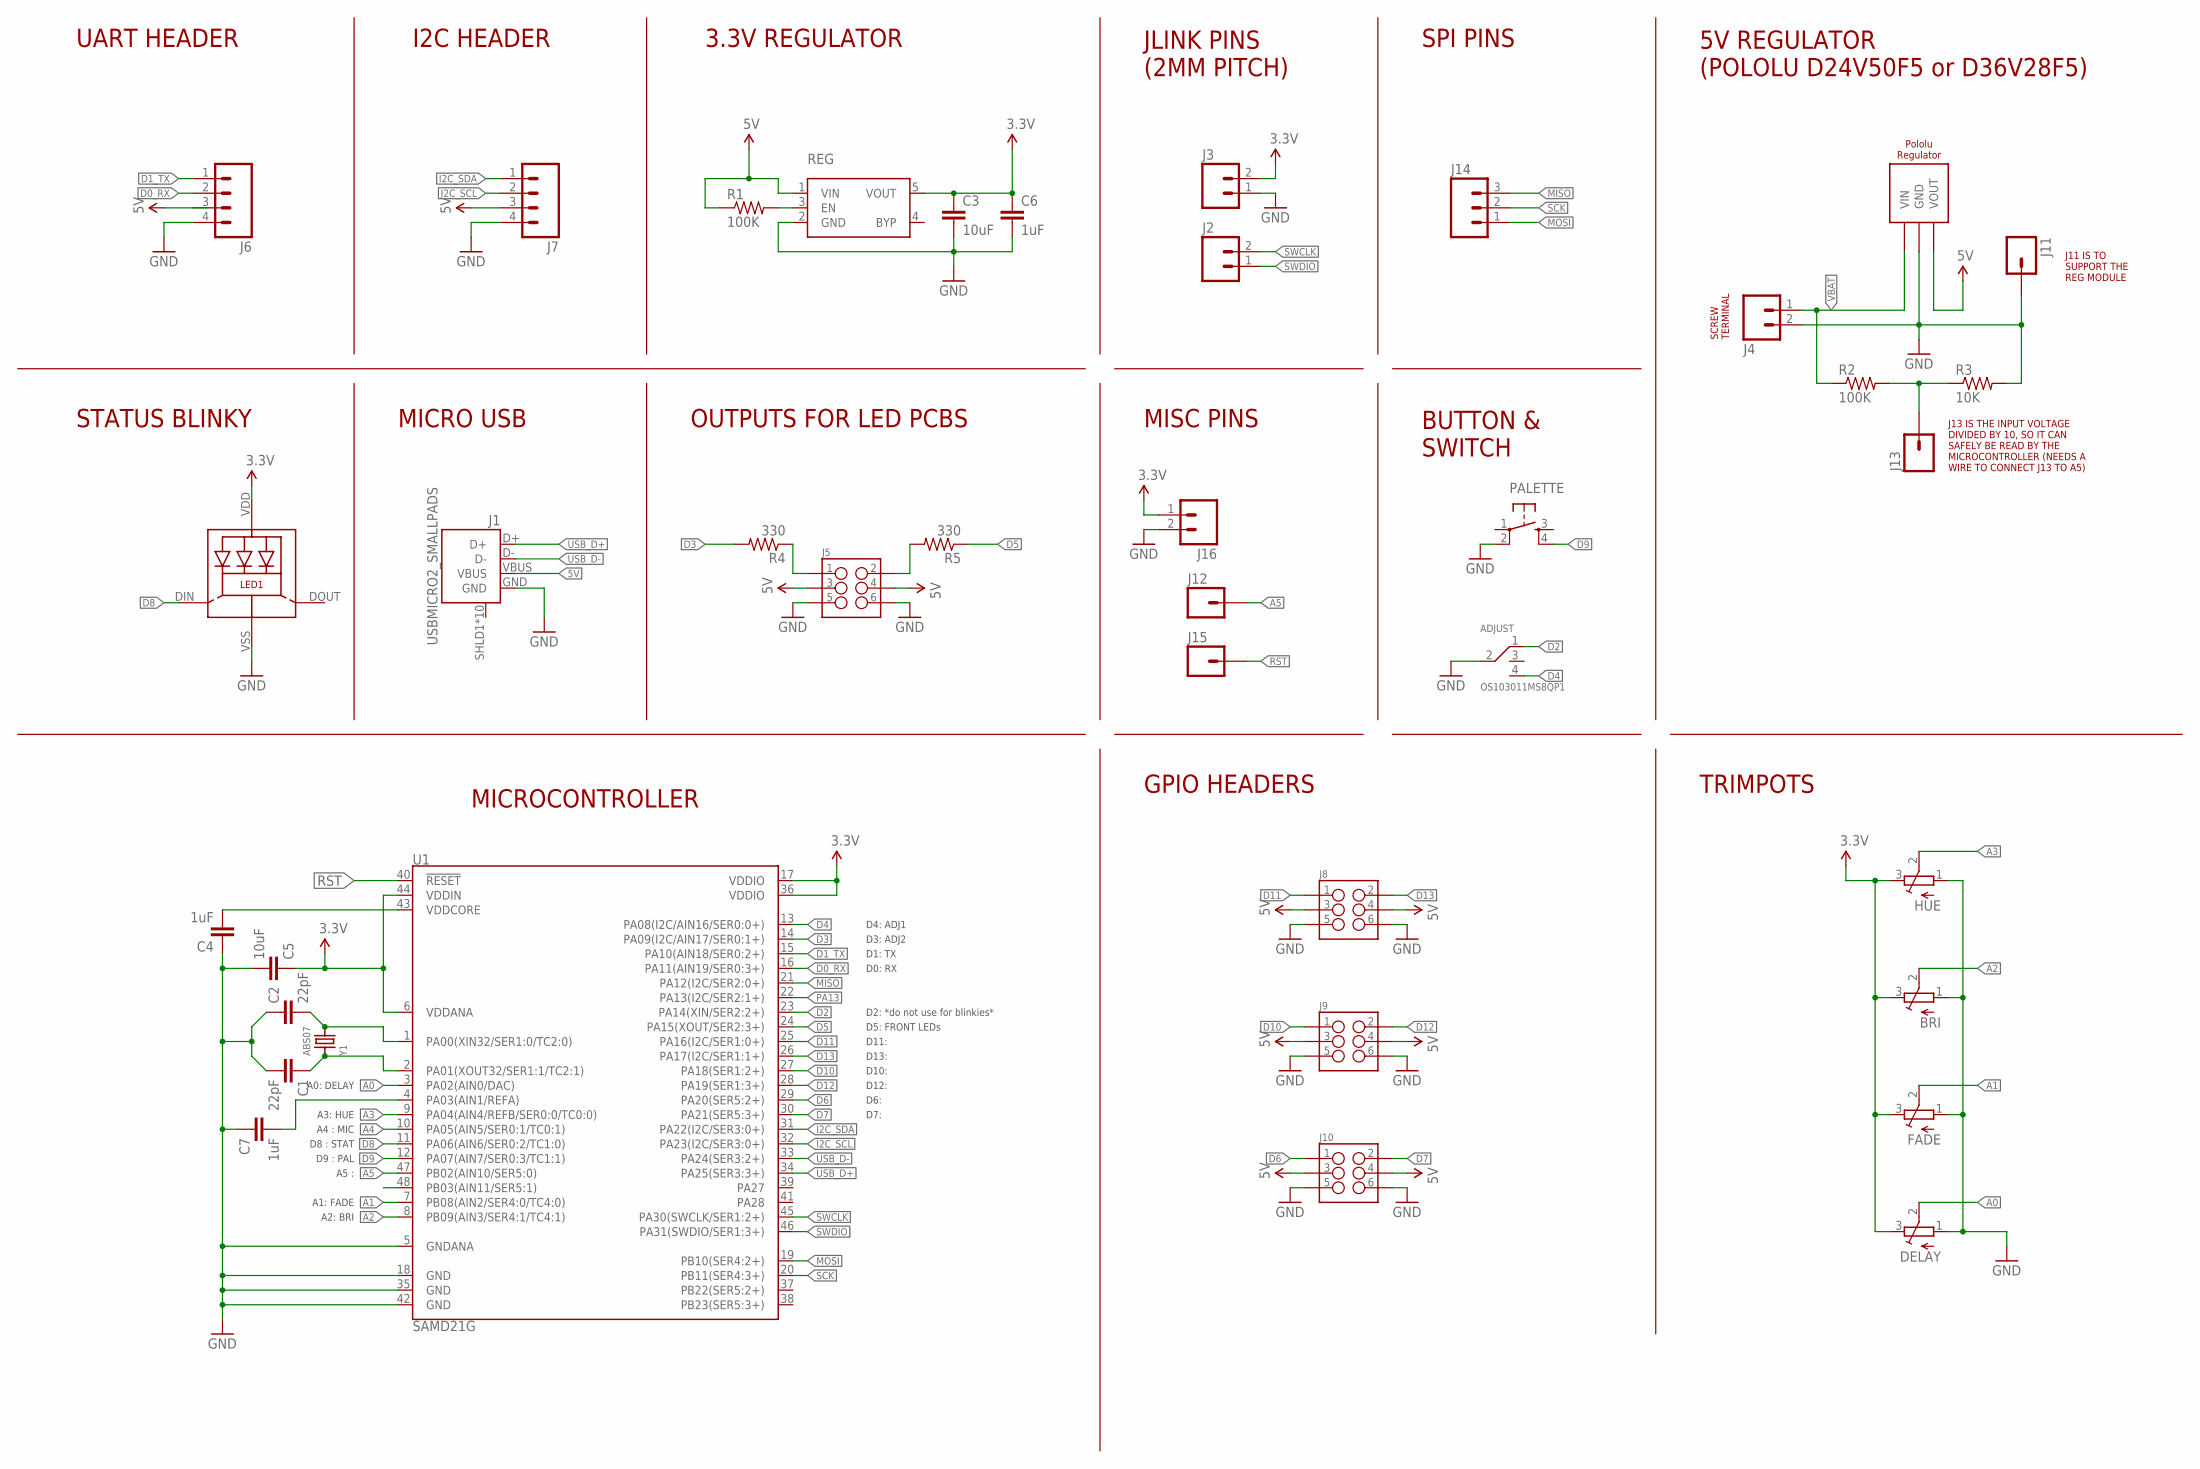
[picture p63: schematic Reactor_Zero.sch]

Parts:
ADJUST: OS103011MS8QP1
BRI: TRIMPOTEVM3V; EVM3V
C1, C2: 22pF; C0603K
C3, C5: 10uF; C0805K
C4, C6, C7: 1uF; C0805K
DELAY: TRIMPOTEVM3V; EVM3V
FADE: TRIMPOTEVM3V; EVM3V
HUE: TRIMPOTEVM3V; EVM3V
J1: USBMICRO2_SMALLPADS; USB-MICROB-10118194_SMALLPADS
J2, J3: M022MM; 1X02_NO_SILK_2MM
J4: M025MM; SCREWTERMINAL-5MM-2
J5, J8, J9, J10: M03X22X3_SILK_MALE_PTH; 2X3
J6, J7: M04PTH; 1X04
J11, J12, J13, J15: M01PTH; 1X01
J14: M03PTH; 1X03
J16: M02PTH; 1X02
LED1: WS2812BSK6812MINI-WIDE; SK6812MINI-WIDE
PALETTE: TAC_SWITCHPTH; TACTILE-PTH
R1, R2: 100K; R0603
R3: 10K; R0603
R4, R5: 330; R0603
REG: SPX3819; SOT23-5
U1: SAMD21G; TQFP-48_SMALL_PADS
U$1: POLOLU_REGD24V50FS_NO_HOLES; D24V50F5_NO_HOLES
Y1: ABS07

Connections:
3.3V: BRI.3 (E), C3.1, C5.1, C6.1, DELAY.3 (E), FADE.3 (E), HUE.3 (E), J3.2, J16.1, LED1.VDD, REG.5 (VOUT), U1.6 (VDDANA), U1.17 (VDDIO), U1.36 (VDDIO), U1.44 (VDDIN)
5V: J1.VBUS, J5.3, J5.4, J6.3, J7.3, J8.3, J8.4, J9.3, J9.4, J10.3, J10.4, R1.1, REG.1 (VIN), U$1.VOUT
A0: DELAY.2 (S), U1.3 (PA02(AIN0/DAC))
A1: FADE.2 (S), U1.7 (PB08(AIN2/SER4:0/TC4:0))
A2: BRI.2 (S), U1.8 (PB09(AIN3/SER4:1/TC4:1))
A3: HUE.2 (S), U1.9 (PA04(AIN4/REFB/SER0:0/TC0:0))
A4: U1.10 (PA05(AIN5/SER0:1/TC0:1))
A5: J12.1, U1.47 (PB02(AIN10/SER5:0))
AREF: C7.2, U1.4 (PA03(AIN1/REFA))
D0_RX: J6.2, U1.16 (PA11(AIN19/SER0:3+))
D1_TX: J6.1, U1.15 (PA10(AIN18/SER0:2+))
D2: ADJUST.1 (T1), U1.23 (PA14(XIN/SER2:2+))
D3: R4.2, U1.14 (PA09(I2C/AIN17/SER0:1+))
D4: ADJUST.4 (T3), U1.13 (PA08(I2C/AIN16/SER0:0+))
D5: R5.1, U1.24 (PA15(XOUT/SER2:3+))
D6: J10.1, U1.29 (PA20(SER5:2+))
D7: J10.2, U1.30 (PA21(SER5:3+))
D8: LED1.DIN (DI), U1.11 (PA06(AIN6/SER0:2/TC1:0))
D9: PALETTE.4, U1.12 (PA07(AIN7/SER0:3/TC1:1))
D10: J9.1, U1.27 (PA18(SER1:2+))
D11: J8.1, U1.25 (PA16(I2C/SER1:0+))
D12: J9.2, U1.28 (PA19(SER1:3+))
D13: J8.2, U1.26 (PA17(I2C/SER1:1+))
DIV: J13.1, R2.2, R3.1
GND: ADJUST.2, BRI.1 (A), C1.2, C2.1, C3.2, C4.1, C5.2, C6.2, C7.1, DELAY.1 (A), FADE.1 (A), HUE.1 (A), J1.GND, J3.1, J4.2, J5.5, J5.6, J6.4, J7.4, J8.5, J8.6, J9.5, J9.6, J10.5, J10.6, J11.1, J16.2, LED1.VSS (GND), PALETTE.2, R3.2, REG.2 (GND), U1.5 (GNDANA), U1.18 (GND), U1.35 (GND), U1.42 (GND), U$1.GND1 (GND), U$1.GND2 (GND)
I2C_SCL: J7.2, U1.32 (PA23(I2C/SER3:0+))
I2C_SDA: J7.1, U1.31 (PA22(I2C/SER3:0+))
MISO: J14.3, U1.21 (PA12(I2C/SER2:0+))
MOSI: J14.1, U1.19 (PB10(SER4:2+))
unnamed: C2.2, U1.1 (PA00(XIN32/SER1:0/TC2:0)), Y1.2
unnamed: C1.1, U1.2 (PA01(XOUT32/SER1:1/TC2:1)), Y1.1
unnamed: J5.2, R5.2
unnamed: R1.2, REG.3 (EN)
unnamed: J5.1, R4.1
unnamed: C4.2, U1.43 (VDDCORE)
PA13: U1.22 (PA13(I2C/SER2:1+))
RST: J15.1, U1.40 (!RESET!)
SCK: J14.2, U1.20 (PB11(SER4:3+))
SWCLK: J2.2, U1.45 (PA30(SWCLK/SER1:2+))
SWDIO: J2.1, U1.46 (PA31(SWDIO/SER1:3+))
USB_D+: J1.D+, U1.34 (PA25(SER3:3+))
USB_D-: J1.D-, U1.33 (PA24(SER3:2+))
VBAT: J4.1, R2.1, U$1.VIN

Notes on the sheet:
A0: DELAY A3: HUE A4 : MIC D8 : STAT D9 : PAL A5 : A1: FADE A2: BRI
D4: ADJ1 D3: ADJ2 D1: TX D0: RX D2: *do not use for blinkies* D5: FRONT LEDs D11: D13: D10: D12: D6: D7:
STATUS BLINKY
MICRO USB
OUTPUTS FOR LED PCBS
MICROCONTROLLER
UART HEADER
I2C HEADER
3.3V REGULATOR
JLINK PINS (2MM PITCH)
SPI PINS
5V REGULATOR (POLOLU D24V50F5 or D36V28F5)
J11 IS TO SUPPORT THE REG MODULE
J13 IS THE INPUT VOLTAGE DIVIDED BY 10, SO IT CAN SAFELY BE READ BY THE MICROCONTROLLER (NEEDS A WIRE TO CONNECT J13 TO A5)
SCREW TERMINAL
MISC PINS
BUTTON & SWITCH
GPIO HEADERS
TRIMPOTS

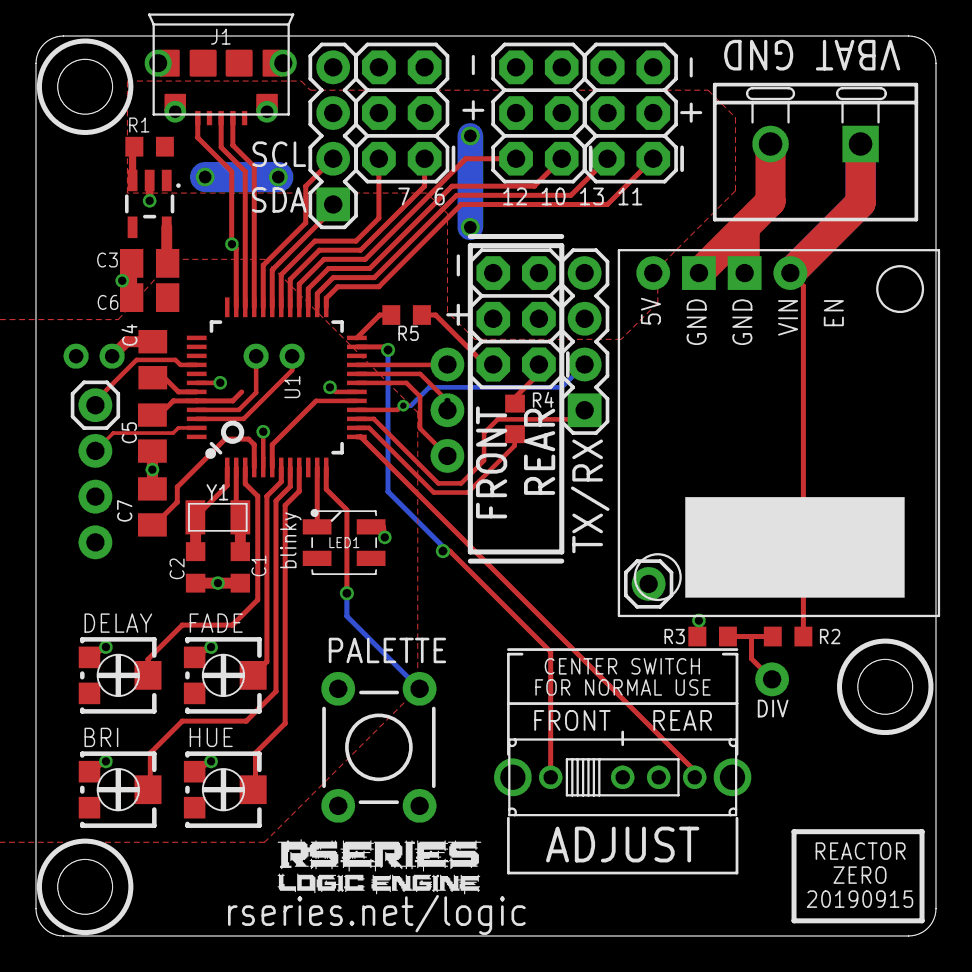
[picture p64: board Reactor_Zero.brd from above]

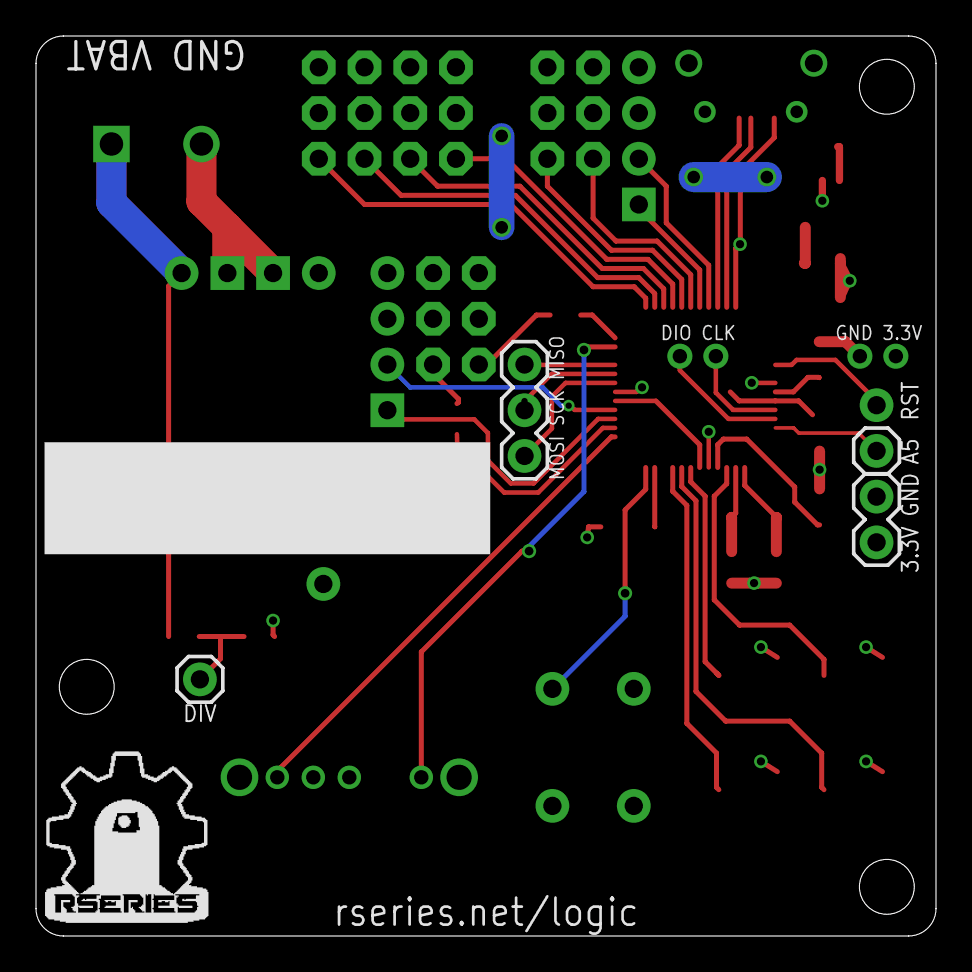
[picture p65: board Reactor_Zero.brd from below]

Board: 2 copper layers, 50.0 x 50.0 mm, 41 parts (5 on the bottom side), 41 nets.

Other parts of the board:
U$2: RSERIES_SMALL
U$4: RSERIES-LE-LOGO2
