joymonkey/logicengine/Hardware Designs/Teensy Reactor.brd

## EAGLE design Hardware Designs/Teensy Reactor.brd (2018-04-08)

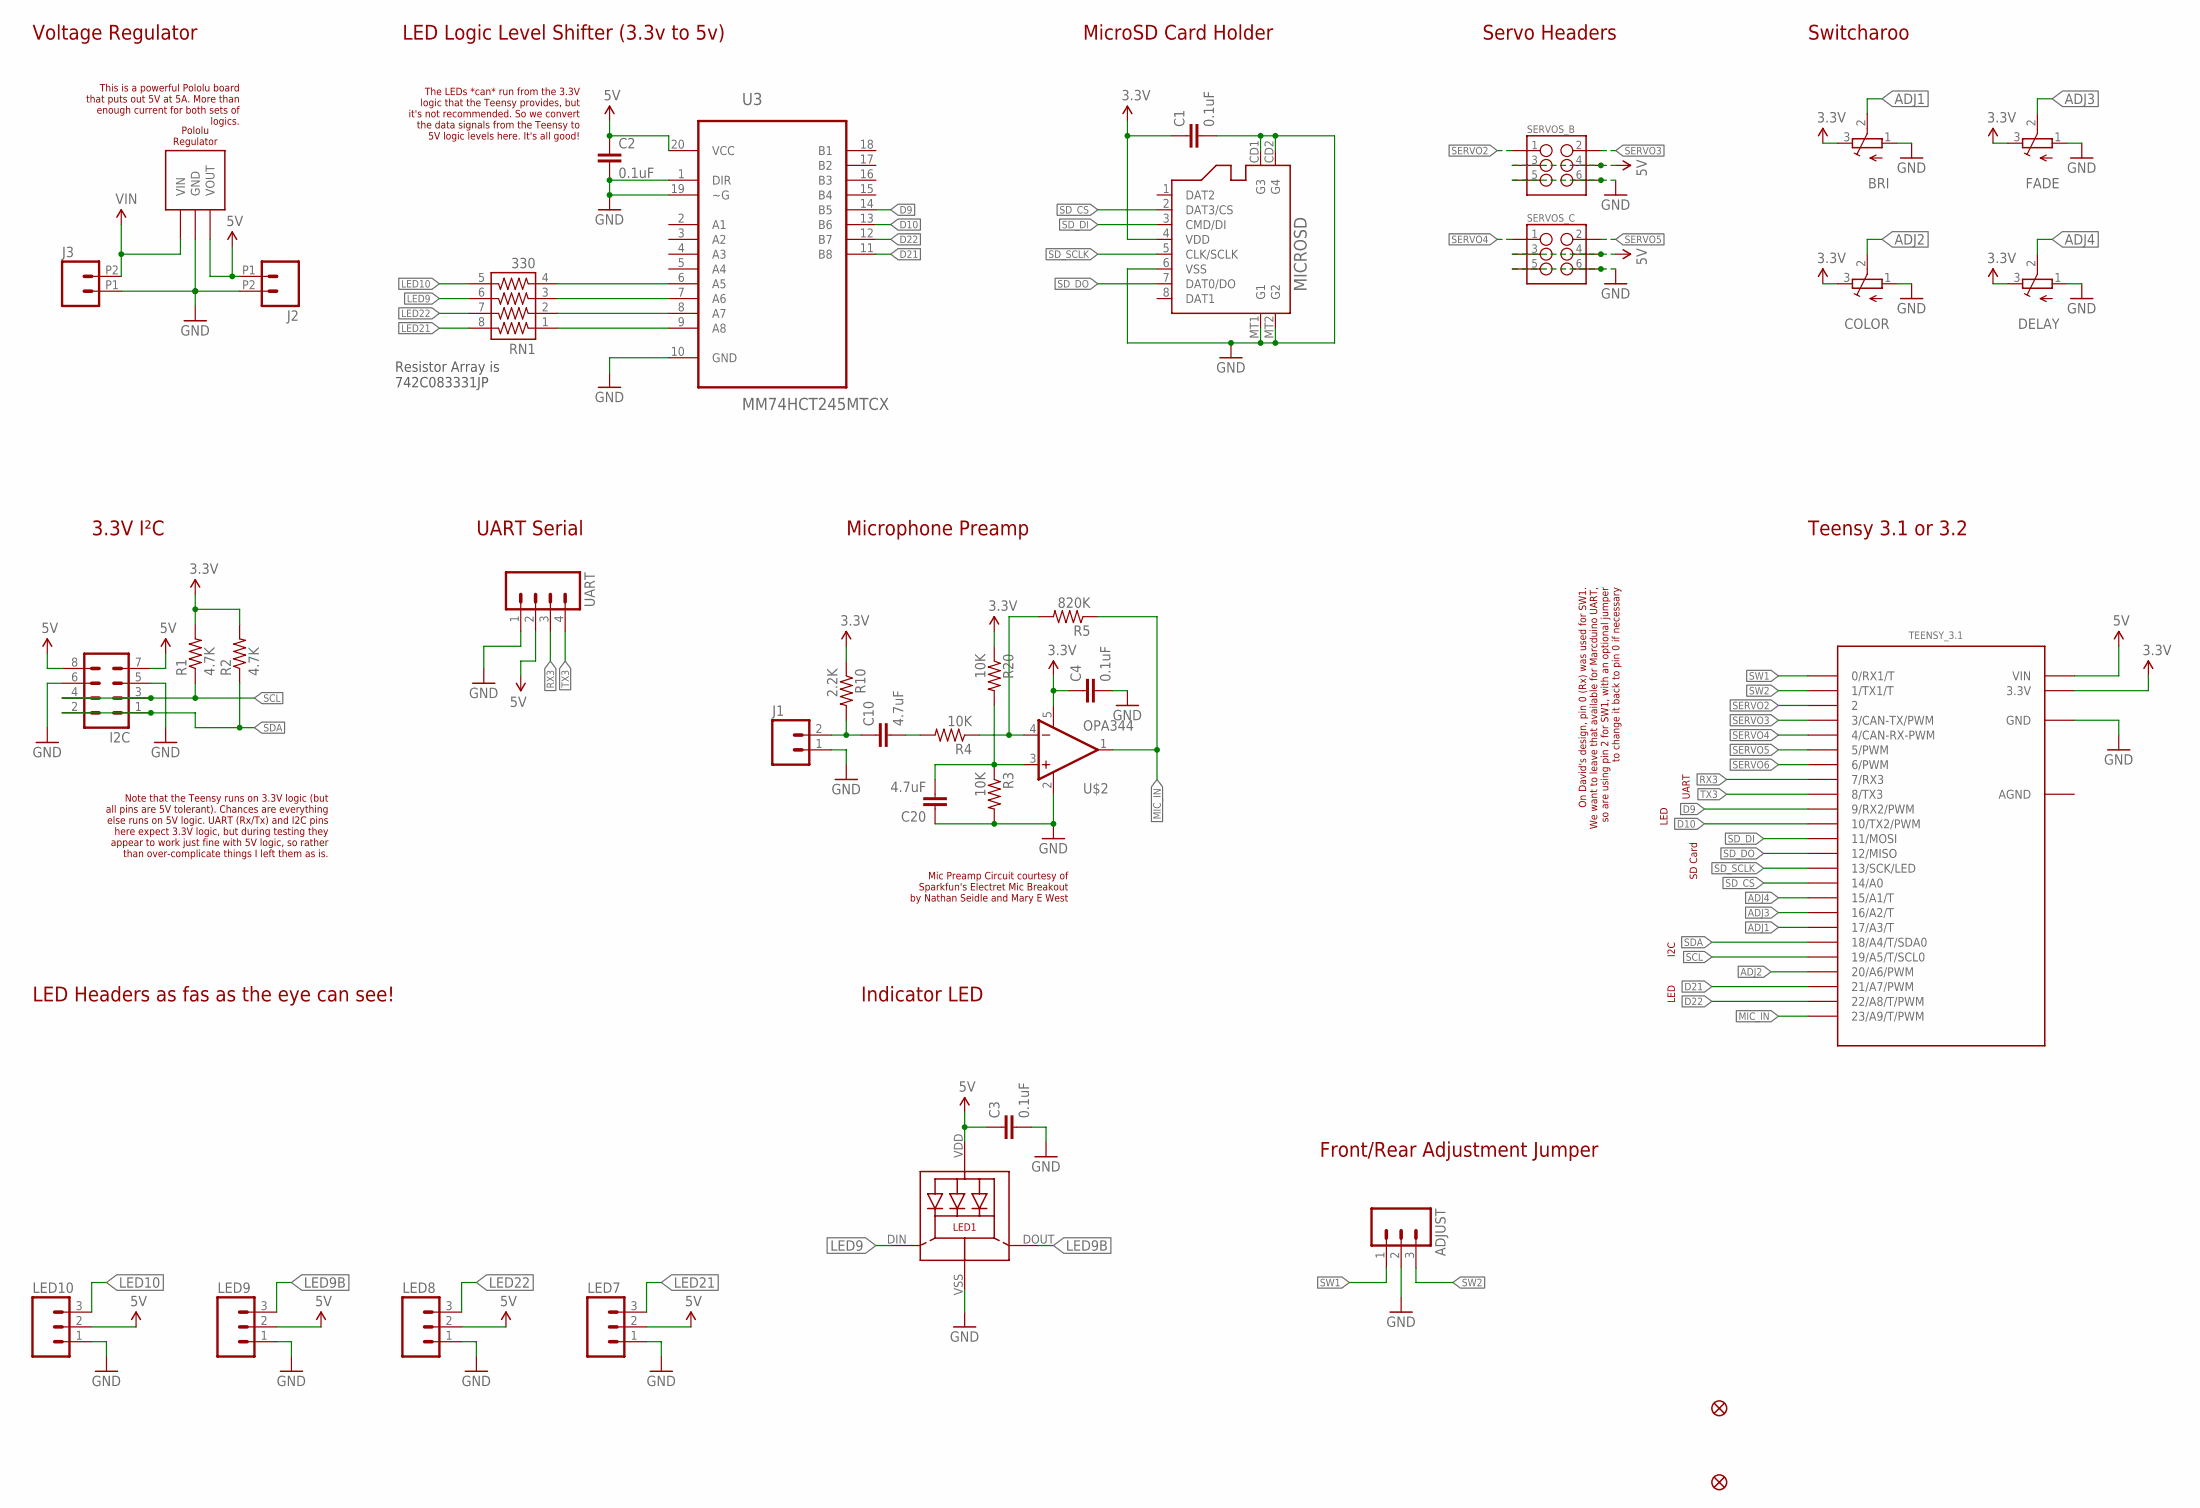
[picture p66: schematic Teensy Reactor.sch]

Parts:
ADJUST: M03PTH; 1X03
BRI: TRIMPOTEVM3V; EVM3V
C1, C2, C3, C4: 0.1uF; 0603-CAP
C10, C20: 4.7uF; 0603-CAP
COLOR: TRIMPOTEVM3V; EVM3V
DELAY: TRIMPOTEVM3V; EVM3V
FADE: TRIMPOTEVM3V; EVM3V
FID1, FID2: FIDUCIAL1X2; FIDUCIAL-1X2
I2C: M04X2; 2X4
J1: M02PTH; 1X02
J2, J3: M022.54MM_SCREWTERM; 1X02_2.54_SCREWTERM
LED1: WS2812BSK6812MINI; SK6812MINI
LED7, LED8, LED9, LED10: M03PTH; 1X03
MICROSD: MICROSD; MICROSD_SMALL
R1, R2: 4.7K; 0603-RES
R3, R4, R20: 10K; 0603-RES
R5: 820K; 0603-RES
R10: 2.2K; 0603-RES
RN1: 330; 742-8NS
SERVOS_B: M03X22X3_SILK_MALE_PTH; 2X3
SERVOS_C: M03X22X3_SILK_MALE_PTH; 2X3
TEENSY_3.1: TEENSY_3.1_SOME_PINS; TEENSY3-SOME_PINS
U3: MM74HCT245MTCX; SOP65P640X120-20N
U$1: POLOLU_REGD24V50FS_NO_HOLES; D24V50F5_NO_HOLES
U$2: OPA344; SOT23-5
UART: M04PTH; 1X04

Connections:
3.3V: BRI.3 (E), C1.1, C4.1, COLOR.3 (E), DELAY.3 (E), FADE.3 (E), MICROSD.4 (VDD), R1.2, R2.2, R10.1, R20.1, TEENSY_3.1.3.3V, TEENSY_3.1.3.3V1 (3.3V), U$2.5 (V+)
5V: C2.1, C3.1, I2C.7, I2C.8, J2.P1 (1), LED1.VDD, LED7.2, LED8.2, LED9.2, LED10.2, SERVOS_B.3, SERVOS_B.4, SERVOS_C.3, SERVOS_C.4, TEENSY_3.1.VIN, U3.20 (VCC), U$1.VOUT, UART.2
ADJ1: BRI.2 (S), TEENSY_3.1.17/A3 (17/A3/T)
ADJ2: COLOR.2 (S), TEENSY_3.1.20/A6 (20/A6/PWM)
ADJ3: FADE.2 (S), TEENSY_3.1.16/A2 (16/A2/T)
ADJ4: DELAY.2 (S), TEENSY_3.1.15/A1 (15/A1/T)
AGND: TEENSY_3.1.AGND
D9: TEENSY_3.1.9 (9/RX2/PWM), U3.14 (B5)
D10: TEENSY_3.1.10 (10/TX2/PWM), U3.13 (B6)
D21: TEENSY_3.1.21/A7 (21/A7/PWM), U3.11 (B8)
D22: TEENSY_3.1.22/A8 (22/A8/T/PWM), U3.12 (B7)
GND: ADJUST.2, BRI.1 (A), C1.2, C2.2, C3.2, C4.2, C20.1, COLOR.1 (A), DELAY.1 (A), FADE.1 (A), I2C.5, I2C.6, J1.1, J2.P2 (2), J3.P1 (1), LED1.VSS (GND), LED7.1, LED8.1, LED9.1, LED10.1, MICROSD.6 (VSS), MICROSD.CD1 (G3), MICROSD.CD2 (G4), MICROSD.MT1 (G1), MICROSD.MT2 (G2), R3.2, SERVOS_B.5, SERVOS_B.6, SERVOS_C.5, SERVOS_C.6, TEENSY_3.1.GND, TEENSY_3.1.GND1 (GND), U3.1 (DIR), U3.10 (GND), U3.19 (~G), U$1.GND1 (GND), U$1.GND2 (GND), U$2.2 (V-), UART.1
LED9: LED1.DIN (DI), RN1.6
LED9B: LED1.DOUT (DO), LED9.3
LED10: LED10.3, RN1.5
LED21: LED7.3, RN1.8
LED22: LED8.3, RN1.7
MIC_IN: R5.1, TEENSY_3.1.23/A9 (23/A9/T/PWM), U$2.1 (OUT)
unnamed: R4.1, R5.2, U$2.4 (-IN)
unnamed: C20.2, R3.1, R20.2, U$2.3 (+IN)
unnamed: C10.1, J1.2, R10.2
unnamed: RN1.1, U3.9 (A8)
unnamed: RN1.2, U3.8 (A7)
unnamed: RN1.3, U3.7 (A6)
unnamed: RN1.4, U3.6 (A5)
unnamed: C10.2, R4.2
RX3: TEENSY_3.1.7 (7/RX3), UART.3
SCL: I2C.3, I2C.4, R1.1, TEENSY_3.1.19/A5 (19/A5/T/SCL0)
SDA: I2C.1, I2C.2, R2.1, TEENSY_3.1.18/A4 (18/A4/T/SDA0)
SD_CS: MICROSD.2 (DAT3/CS), TEENSY_3.1.14/A0
SD_DI: MICROSD.3 (CMD/DI), TEENSY_3.1.11 (11/MOSI)
SD_DO: MICROSD.7 (DAT0/DO), TEENSY_3.1.12 (12/MISO)
SD_SCLK: MICROSD.5 (CLK/SCLK), TEENSY_3.1.13 (13/SCK/LED)
SERVO2: SERVOS_B.1, TEENSY_3.1.2
SERVO3: SERVOS_B.2, TEENSY_3.1.3 (3/CAN-TX/PWM)
SERVO4: SERVOS_C.1, TEENSY_3.1.4 (4/CAN-RX-PWM)
SERVO5: SERVOS_C.2, TEENSY_3.1.5 (5/PWM)
SERVO6: TEENSY_3.1.6 (6/PWM)
SW1: ADJUST.1, TEENSY_3.1.0 (0/RX1/T)
SW2: ADJUST.3, TEENSY_3.1.1 (1/TX1/T)
TX3: TEENSY_3.1.8 (8/TX3), UART.4
VIN: J3.P2 (2), U$1.VIN

Notes on the sheet:
Voltage Regulator
LED Headers as fas as the eye can see!
MicroSD Card Holder
LED Logic Level Shifter (3.3v to 5v)
3.3V I²C
Resistor Array is 742C083331JP
On David's design, pin 0 (Rx) was used for SW1. We want to leave that available for Marcduino UART, so are using pin 2 for SW1, with an optional jumper to change it back to pin 0 if necessary
Switcharoo
Note that the Teensy runs on 3.3V logic (but all pins are 5V tolerant). Chances are everything else runs on 5V logic. UART (Rx/Tx) and I2C pins here expect 3.3V logic, but during testing they appear to work just fine with 5V logic, so rather than over-complicate things I left them as is.
This is a powerful Pololu board that puts out 5V at 5A. More than enough current for both sets of logics.
The LEDs *can* run from the 3.3V logic that the Teensy provides, but it's not recommended. So we convert the data signals from the Teensy to 5V logic levels here. It's all good!
Servo Headers
Mic Preamp Circuit courtesy of Sparkfun's Electret Mic Breakout by Nathan Seidle and Mary E West
Microphone Preamp
UART Serial
Teensy 3.1 or 3.2
Indicator LED
Front/Rear Adjustment Jumper
LED
UART
I2C
SD Card

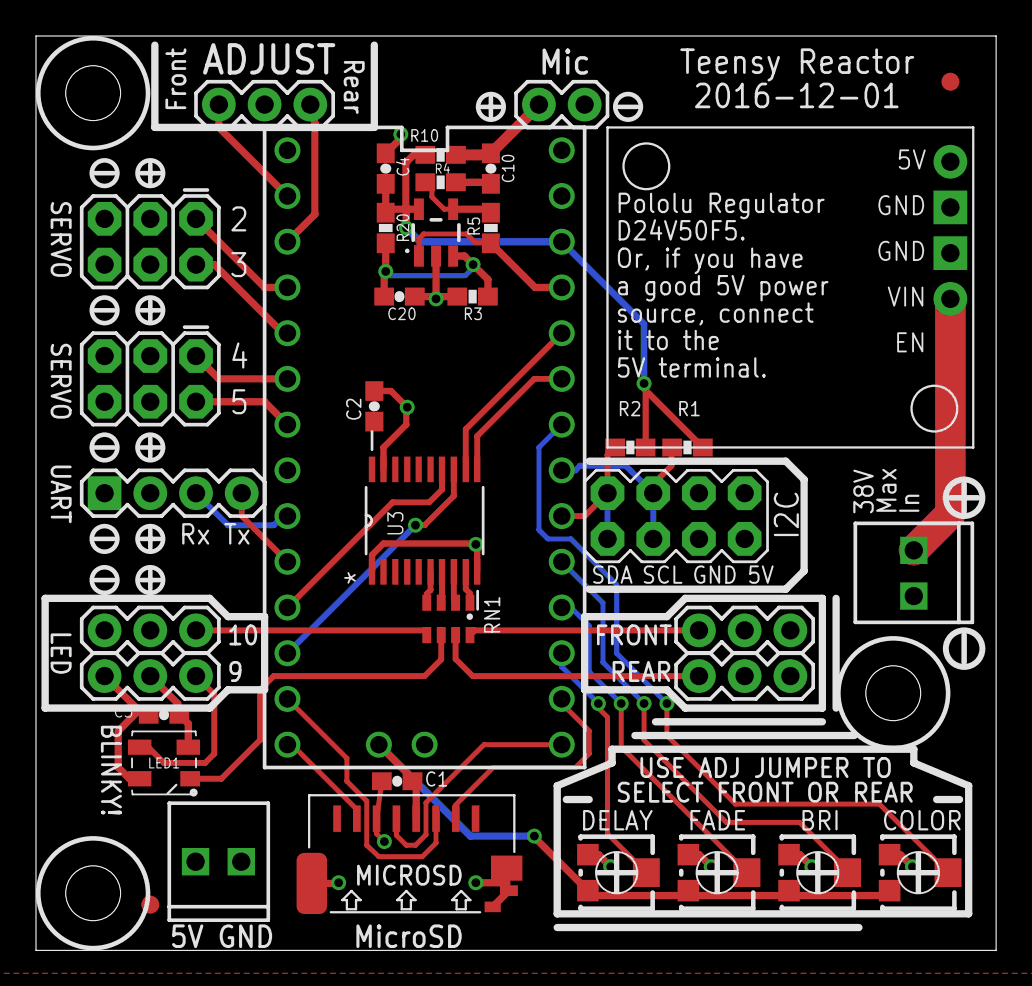
[picture p67: board Teensy Reactor.brd from above]

Board: 2 copper layers, 53.3 x 50.8 mm, 38 parts (0 on the bottom side), 40 nets.
