joymonkey/logicengine/Hardware Designs/Logic Engine - Front SK6812.brd

## EAGLE design Hardware Designs/Logic Engine - Front SK6812.brd (2016-12-14)

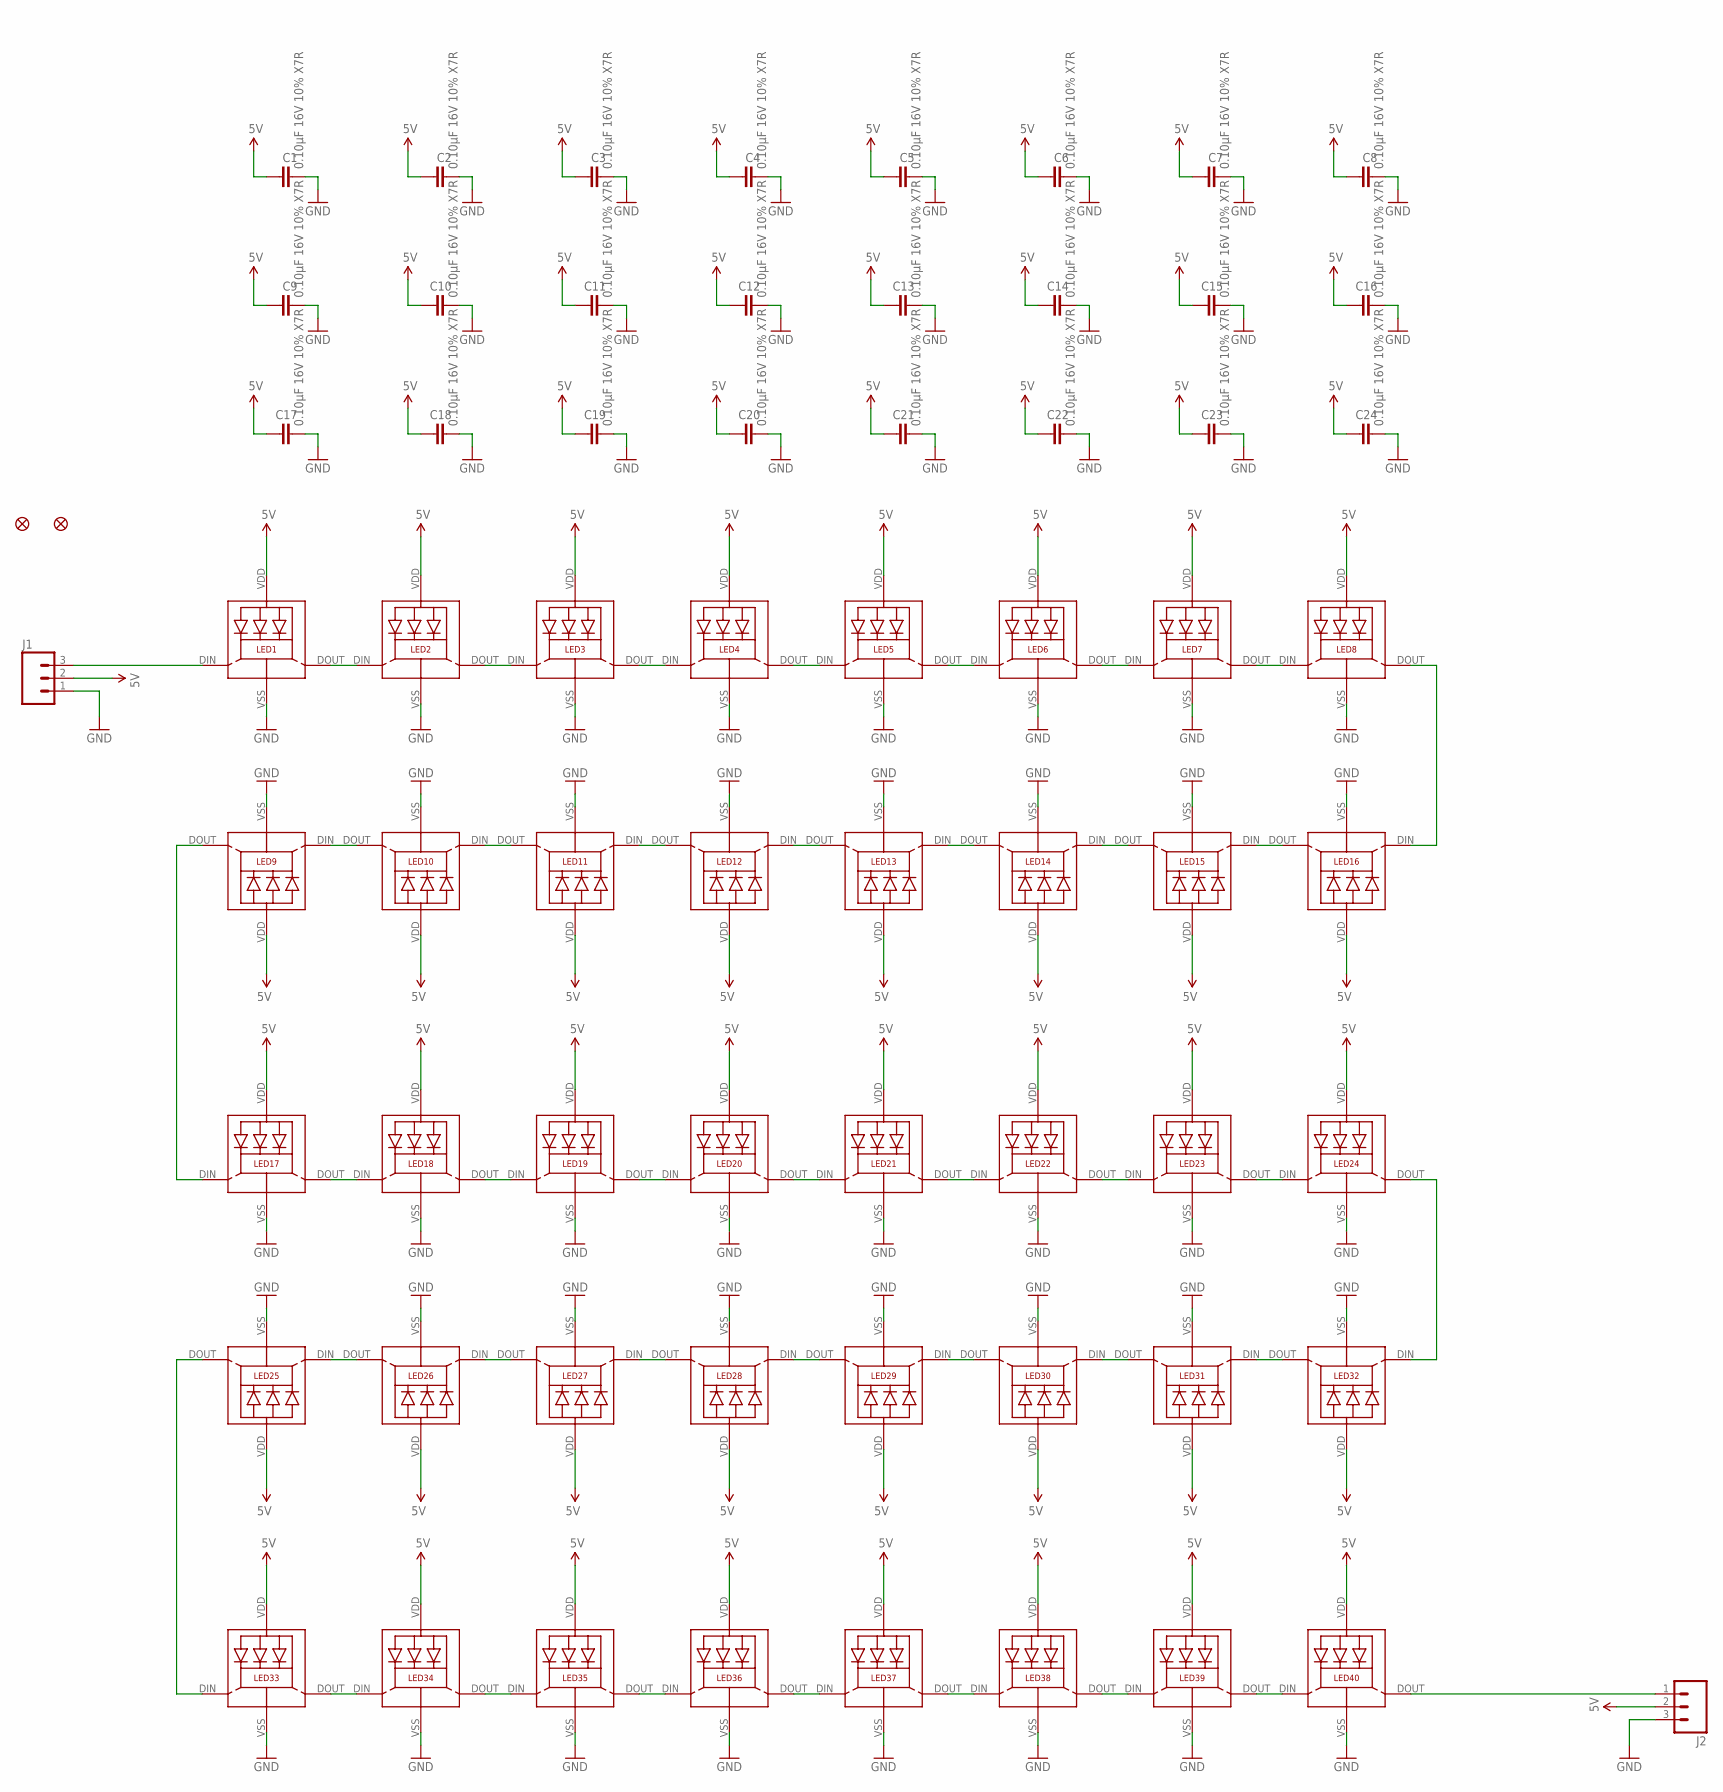
[picture p68: schematic Logic Engine - Front SK6812.sch]

Parts:
C1, C2, C3, C4, C5, C6, C7, C8, C9, C10, C11, C12, C13, C14, C15, C16, C17, C18, C19, C20, C21, C22, C23, C24: 0.10µF 16V 10% X7R; C0603
FD1, FD2: FIDUCIAL1X2; FIDUCIAL-1X2
J1, J2: M03PTH; 1X03
LED1, LED2, LED3, LED4, LED5, LED6, LED7, LED8, LED9, LED10, LED11, LED12, LED13, LED14, LED15, LED16, LED17, LED18, LED19, LED20, LED21, LED22, LED23, LED24, LED25, LED26, LED27, LED28, LED29, LED30, LED31, LED32, LED33, LED34, LED35, LED36, LED37, LED38, LED39, LED40: WS2812BSK6812MINI; SK6812MINI

Connections:
5V: C1.1, C2.1, C3.1, C4.1, C5.1, C6.1, C7.1, C8.1, C9.1, C10.1, C11.1, C12.1, C13.1, C14.1, C15.1, C16.1, C17.1, C18.1, C19.1, C20.1, C21.1, C22.1, C23.1, C24.1, J1.2, J2.2, LED1.VDD, LED2.VDD, LED3.VDD, LED4.VDD, LED5.VDD, LED6.VDD, LED7.VDD, LED8.VDD, LED9.VDD, LED10.VDD, LED11.VDD, LED12.VDD, LED13.VDD, LED14.VDD, LED15.VDD, LED16.VDD, LED17.VDD, LED18.VDD, LED19.VDD, LED20.VDD, LED21.VDD, LED22.VDD, LED23.VDD, LED24.VDD, LED25.VDD, LED26.VDD, LED27.VDD, LED28.VDD, LED29.VDD, LED30.VDD, LED31.VDD, LED32.VDD, LED33.VDD, LED34.VDD, LED35.VDD, LED36.VDD, LED37.VDD, LED38.VDD, LED39.VDD, LED40.VDD
GND: C1.2, C2.2, C3.2, C4.2, C5.2, C6.2, C7.2, C8.2, C9.2, C10.2, C11.2, C12.2, C13.2, C14.2, C15.2, C16.2, C17.2, C18.2, C19.2, C20.2, C21.2, C22.2, C23.2, C24.2, J1.1, J2.3, LED1.VSS (GND), LED2.VSS (GND), LED3.VSS (GND), LED4.VSS (GND), LED5.VSS (GND), LED6.VSS (GND), LED7.VSS (GND), LED8.VSS (GND), LED9.VSS (GND), LED10.VSS (GND), LED11.VSS (GND), LED12.VSS (GND), LED13.VSS (GND), LED14.VSS (GND), LED15.VSS (GND), LED16.VSS (GND), LED17.VSS (GND), LED18.VSS (GND), LED19.VSS (GND), LED20.VSS (GND), LED21.VSS (GND), LED22.VSS (GND), LED23.VSS (GND), LED24.VSS (GND), LED25.VSS (GND), LED26.VSS (GND), LED27.VSS (GND), LED28.VSS (GND), LED29.VSS (GND), LED30.VSS (GND), LED31.VSS (GND), LED32.VSS (GND), LED33.VSS (GND), LED34.VSS (GND), LED35.VSS (GND), LED36.VSS (GND), LED37.VSS (GND), LED38.VSS (GND), LED39.VSS (GND), LED40.VSS (GND)
unnamed: LED1.DOUT (DO), LED2.DIN (DI)
unnamed: LED2.DOUT (DO), LED3.DIN (DI)
unnamed: LED3.DOUT (DO), LED4.DIN (DI)
unnamed: LED4.DOUT (DO), LED5.DIN (DI)
unnamed: LED5.DOUT (DO), LED6.DIN (DI)
unnamed: LED6.DOUT (DO), LED7.DIN (DI)
unnamed: LED7.DOUT (DO), LED8.DIN (DI)
unnamed: LED8.DOUT (DO), LED16.DIN (DI)
unnamed: LED15.DIN (DI), LED16.DOUT (DO)
unnamed: LED14.DIN (DI), LED15.DOUT (DO)
unnamed: LED13.DIN (DI), LED14.DOUT (DO)
unnamed: LED12.DIN (DI), LED13.DOUT (DO)
unnamed: LED11.DIN (DI), LED12.DOUT (DO)
unnamed: LED10.DIN (DI), LED11.DOUT (DO)
unnamed: LED9.DIN (DI), LED10.DOUT (DO)
unnamed: LED17.DOUT (DO), LED18.DIN (DI)
unnamed: LED18.DOUT (DO), LED19.DIN (DI)
unnamed: LED19.DOUT (DO), LED20.DIN (DI)
unnamed: LED20.DOUT (DO), LED21.DIN (DI)
unnamed: LED21.DOUT (DO), LED22.DIN (DI)
unnamed: LED22.DOUT (DO), LED23.DIN (DI)
unnamed: LED23.DOUT (DO), LED24.DIN (DI)
unnamed: LED24.DOUT (DO), LED32.DIN (DI)
unnamed: J2.1, LED40.DOUT (DO)
unnamed: LED9.DOUT (DO), LED17.DIN (DI)
unnamed: LED31.DIN (DI), LED32.DOUT (DO)
unnamed: LED30.DIN (DI), LED31.DOUT (DO)
unnamed: LED29.DIN (DI), LED30.DOUT (DO)
unnamed: LED28.DIN (DI), LED29.DOUT (DO)
unnamed: LED27.DIN (DI), LED28.DOUT (DO)
unnamed: LED26.DIN (DI), LED27.DOUT (DO)
unnamed: LED25.DIN (DI), LED26.DOUT (DO)
unnamed: LED33.DOUT (DO), LED34.DIN (DI)
unnamed: LED34.DOUT (DO), LED35.DIN (DI)
unnamed: LED35.DOUT (DO), LED36.DIN (DI)
unnamed: LED36.DOUT (DO), LED37.DIN (DI)
unnamed: LED37.DOUT (DO), LED38.DIN (DI)
unnamed: LED38.DOUT (DO), LED39.DIN (DI)
unnamed: LED39.DOUT (DO), LED40.DIN (DI)
unnamed: LED25.DOUT (DO), LED33.DIN (DI)
unnamed: J1.3, LED1.DIN (DI)

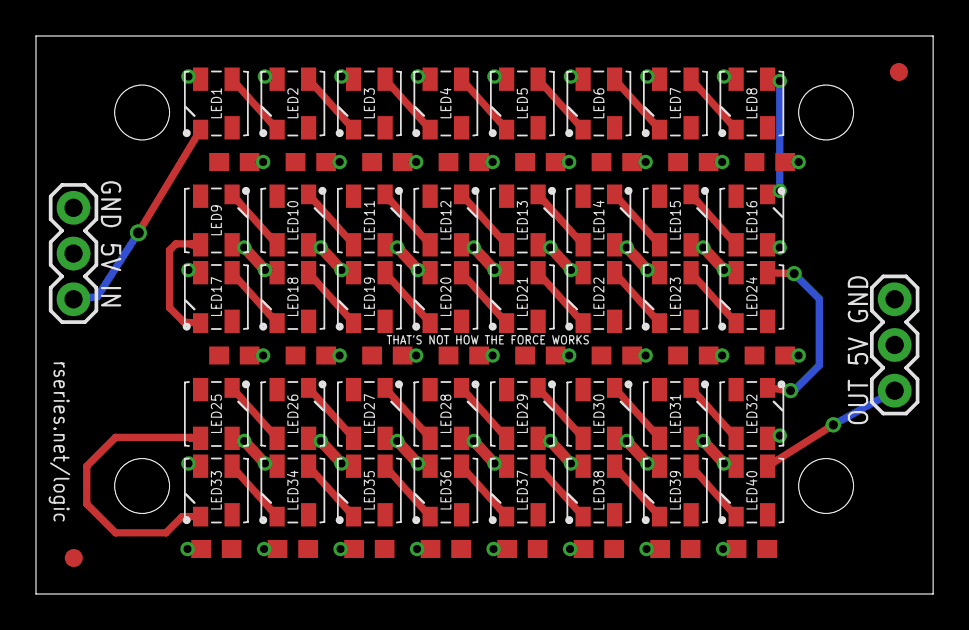
[picture p69: board Logic Engine - Front SK6812.brd from above]

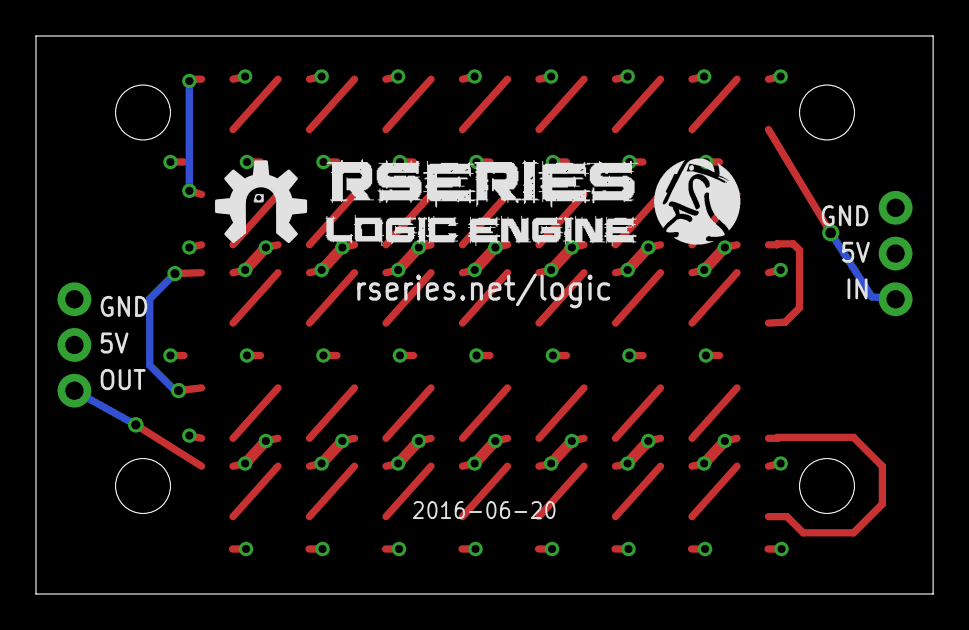
[picture p70: board Logic Engine - Front SK6812.brd from below]

Board: 2 copper layers, 49.8 x 31.0 mm, 71 parts (3 on the bottom side), 43 nets.

Other parts of the board:
U$1: RSERIES-LE-LOGO
U$2: R2BUILDERS-LOGO
U$3: RSERIES-OSHW-LOGO-MEDIUM
