joymonkey/logicengine/Hardware Designs/Logic Engine - AVR.brd

## EAGLE design Hardware Designs/Logic Engine - AVR.brd (2015-10-19)

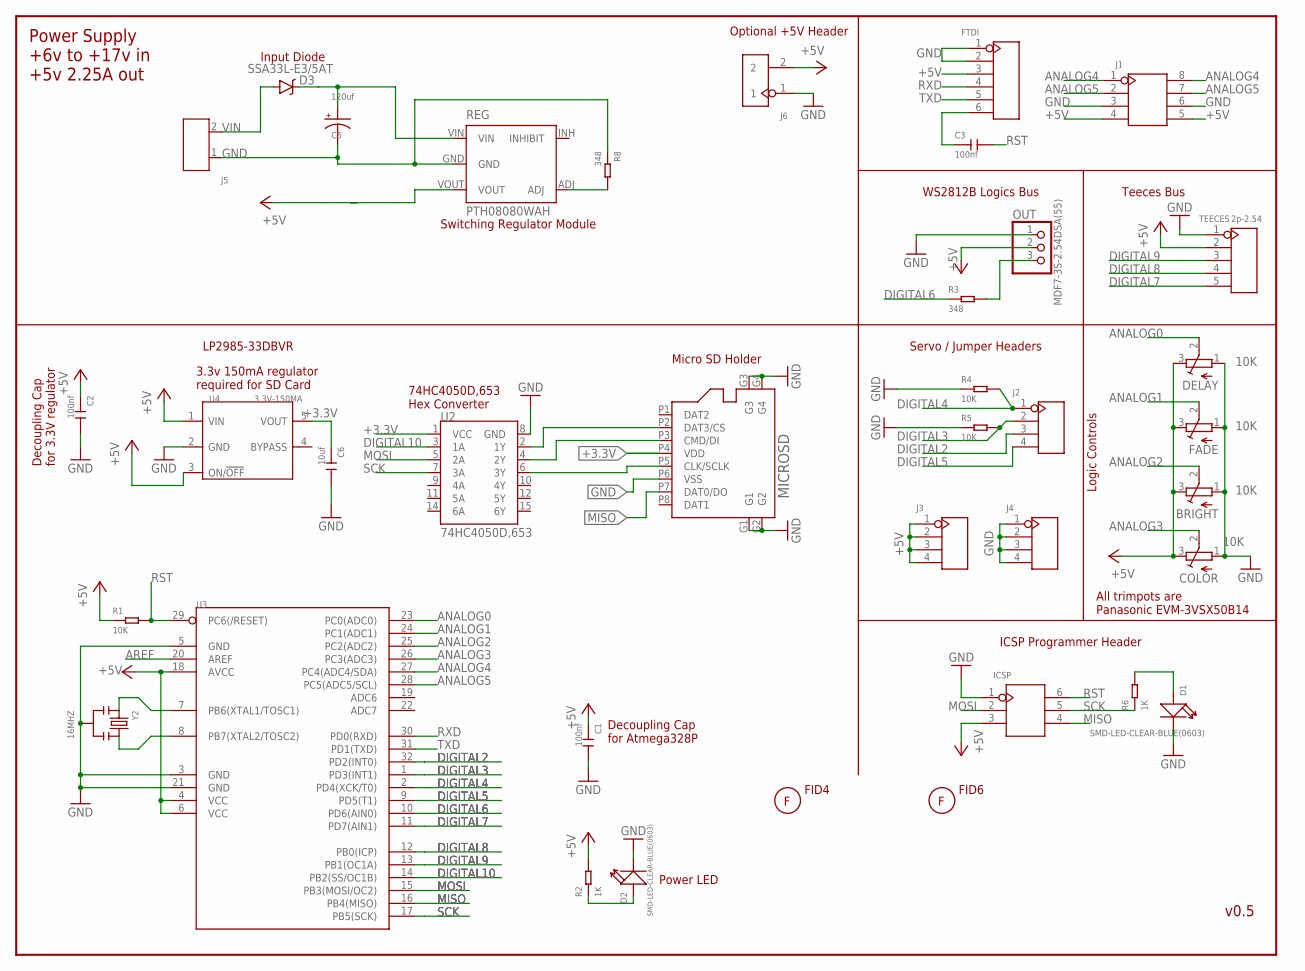
[picture p71: schematic Logic Engine - AVR.sch]

Parts:
BRIGHT: 10K; EVM3V
C1, C2, C3: 100nf; C0805
C5: 120uf; PANASONIC_D
C6: 10uf; C0805
COLOR: 10K; EVM3V
D1, D2: SMD-LED-CLEAR-BLUE(0603); LED-0603
D3: SSA33L-E3/5AT; SMA-DIODE
DELAY: 10K; EVM3V
FADE: 10K; EVM3V
FID4, FID6: FIDUCIAL; FIDUCIAL_G15
FTDI: DIP-BLACK-MALE-HEADER(6P-2.54); H6-2.54
ICSP: DIP-BLACK-MALE-HEADER(2X3P-2.54）-2.54; H2X3-2.54
J1: DIP-BLACK-MALE-HEADER-VERT(2X4P-2.54); H2X4-2.54
J2, J3, J4: DIP-BLACK-MALE-HEADER-VERT(4P-2.54); H4-2.54
J5: SCREW-TERMINAL-GREEN(2P-3.5); H2-3.5-7.0X7.0MM
J6: DIP-BLACK-MALE-HEADER-VERT(2P-2.54); H2-2.54
MICROSD: MICROSD47579-001; SD-47579-001
OUT: MDF7-3S-2.54DSA(55); MDF7_1X03
R1, R4, R5: 10K; R0603
R2, R6: 1K; R0603
R3, R8: 348; R0603
REG: PTH08080WAH; PTH08080W_TH
TEECES: 2p-2.54; H5-2.54
U2: 74HC4050D,653; SO016
U3: MCU-ATMEGA328P-AU(TQFP32); TQFP32-0.8-7X7MM
U4: 3.3V-150MA; SOT-23-5; MPN LP2985-33DBVR
Y2: 16MHZ; X3-SMD-3.6X1.3X0.8MM

Connections:
+3.3V: C6.1, MICROSD.P4 (VDD), U2.1 (VCC), U4.5 (VOUT)
+5V: BRIGHT.3 (E), C1.1, C2.1, COLOR.3 (E), DELAY.3 (E), FADE.3 (E), FTDI.3, ICSP.3, J1.4, J1.5, J3.1, J3.2, J3.3, J3.4, J6.2, OUT.2, R1.1, R2.2, REG.VOUT, TEECES.2, U3.4 (VCC), U3.6 (VCC), U3.18 (AVCC), U4.1 (VIN), U4.3 (ON/!OFF)
ANALOG0: DELAY.2 (S), U3.23 (PC0(ADC0))
ANALOG1: FADE.2 (S), U3.24 (PC1(ADC1))
ANALOG2: BRIGHT.2 (S), U3.25 (PC2(ADC2))
ANALOG3: COLOR.2 (S), U3.26 (PC3(ADC3))
ANALOG4: J1.1, J1.8, U3.27 (PC4(ADC4/SDA))
ANALOG5: J1.2, J1.7, U3.28 (PC5(ADC5/SCL))
AREF: U3.20 (AREF)
CS: MICROSD.P2 (DAT3/CS), U2.2 (1Y)
DATA_IN: MICROSD.P3 (CMD/DI), U2.4 (2Y)
DIGITAL2: J2.3, U3.32 (PD2(INT0))
DIGITAL3: J2.2, R5.2, U3.1 (PD3(INT1))
DIGITAL4: J2.1, R4.2, U3.2 (PD4(XCK/T0))
DIGITAL5: J2.4, U3.9 (PD5(T1))
DIGITAL6: R3.1, U3.10 (PD6(AIN0))
DIGITAL7: TEECES.5, U3.11 (PD7(AIN1))
DIGITAL8: TEECES.4, U3.12 (PB0(ICP))
DIGITAL9: TEECES.3, U3.13 (PB1(OC1A))
DIGITAL10: U2.3 (1A), U3.14 (PB2(SS/OC1B))
GND: BRIGHT.1 (A), C1.2, C2.2, C5.-, C6.2, COLOR.1 (A), D1.-, D2.-, DELAY.1 (A), FADE.1 (A), FTDI.1, FTDI.2, ICSP.1, J1.3, J1.6, J4.1, J4.2, J4.3, J4.4, J5.1, J6.1, MICROSD.G1, MICROSD.G2, MICROSD.G3, MICROSD.G4, MICROSD.P6 (VSS), OUT.1, R4.1, R5.1, R8.1, REG.GND, TEECES.1, U2.8 (GND), U3.3 (GND), U3.5 (GND), U3.21 (GND), U4.2 (GND), Y2.2
MISO: ICSP.4, MICROSD.P7 (DAT0/DO), U3.16 (PB4(MISO))
MOSI: ICSP.2, U2.5 (2A), U3.15 (PB3(MOSI/OC2))
unnamed: C5.+, D3.C, REG.VIN
unnamed: D1.+, R6.2
unnamed: D2.+, R2.1
unnamed: R8.2, REG.ADJ
unnamed: OUT.3, R3.2
unnamed: U3.7 (PB6(XTAL1/TOSC1)), Y2.1
unnamed: U3.8 (PB7(XTAL2/TOSC2)), Y2.3
RST: C3.2, ICSP.6, R1.2, U3.29 (PC6(/RESET))
RTS#: C3.1, FTDI.6
RXD: FTDI.4, U3.30 (PD0(RXD))
SCK: ICSP.5, R6.1, U2.7 (3A), U3.17 (PB5(SCK))
SCLK: MICROSD.P5 (CLK/SCLK), U2.6 (3Y)
TXD: FTDI.5, U3.31 (PD1(TXD))
VIN: D3.A, J5.2

Notes on the sheet:
v0.5
WS2812B Logics Bus
Power Supply +6v to +17v in +5v 2.25A out
Logic Controls
Teeces Bus
3.3v 150mA regulator required for SD Card
Servo / Jumper Headers
Optional +5V Header
74HC4050D,653 Hex Converter
LP2985-33DBVR
All trimpots are Panasonic EVM‑3VSX50B14
Micro SD Holder
Switching Regulator Module
Input Diode
Decoupling Cap for Atmega328P
Decoupling Cap for 3.3V regulator
ICSP Programmer Header
Power LED

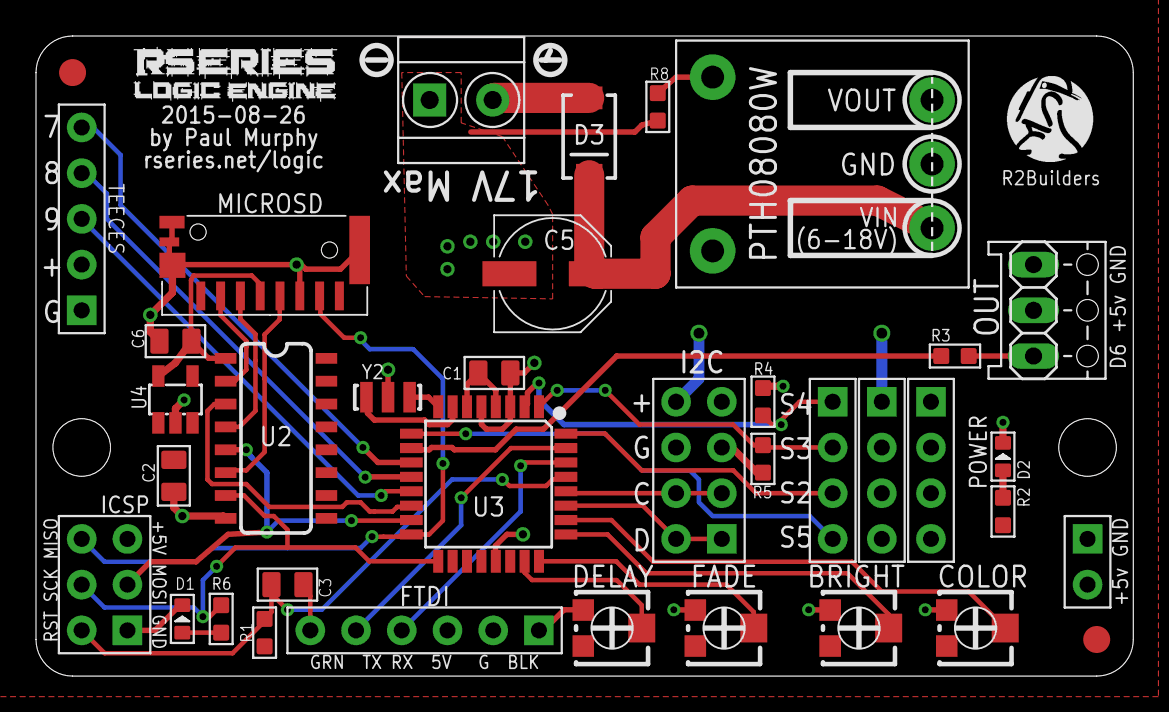
[picture p72: board Logic Engine - AVR.brd from above]

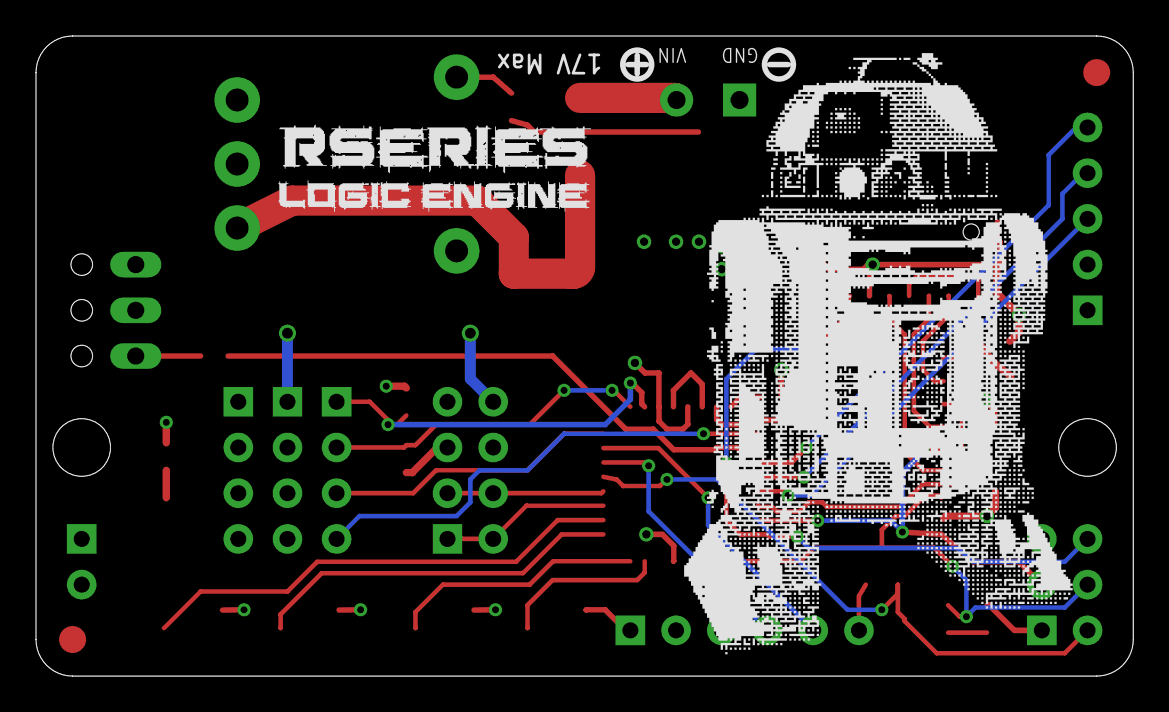
[picture p73: board Logic Engine - AVR.brd from below]

Board: 2 copper layers, 61.0 x 35.6 mm, 41 parts (2 on the bottom side), 36 nets.

Other parts of the board:
U$1: R2BUILDERS-LOGO
U$2: RSERIES-LE-LOGO2
U$3: RSERIES-LE-LOGO
U$4: R2-2LEG
