joymonkey/logicengine/Hardware Designs/Logic Engine - Front LED.brd

## EAGLE design Hardware Designs/Logic Engine - Front LED.brd (2015-10-19)

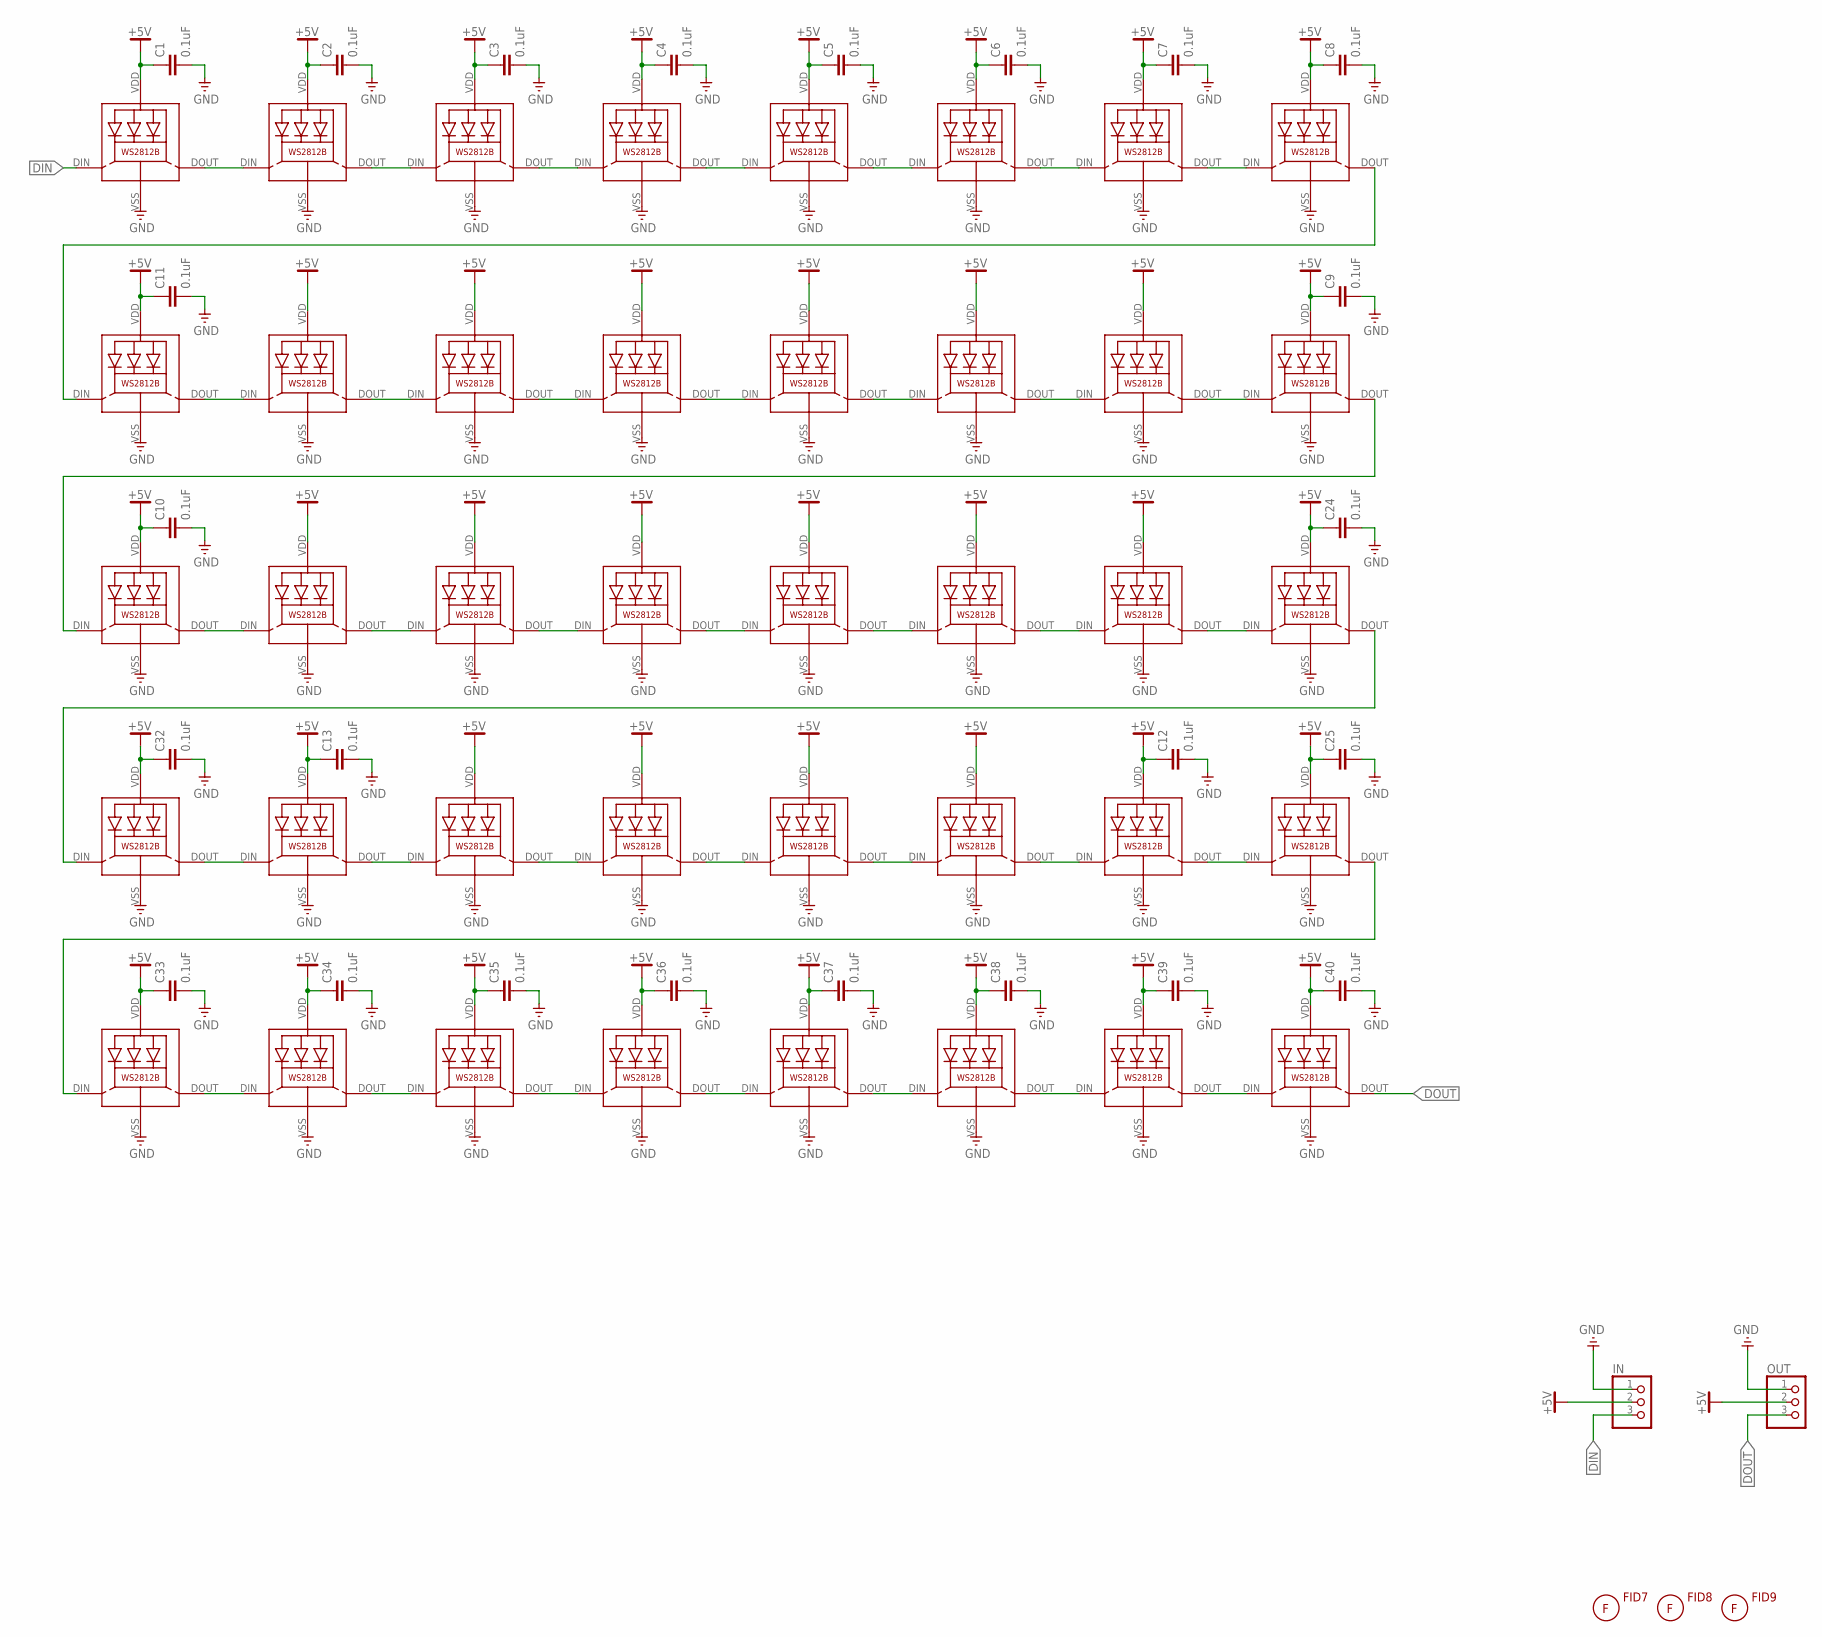
[picture p74: schematic Logic Engine - Front LED.sch]

Parts:
C1, C2, C3, C4, C5, C6, C7, C8, C9, C10, C11, C12, C13, C24, C25, C32, C33, C34, C35, C36, C37, C38, C39, C40: 0.1uF; 0603-CAP
FID7, FID8, FID9: FIDUCIAL; FIDUCIAL_G15
IN: PINHD-1X3; 1X03
L1, L2, L3, L4, L5, L6, L7, L8, L9, L10, L11, L12, L13, L14, L15, L16, L17, L18, L19, L20, L21, L22, L23, L24, L25, L26, L27, L28, L29, L30, L31, L32, L33, L34, L35, L36, L37, L38, L39, L40: WS2812B
OUT: PINHD-1X3; 1X03

Connections:
+5V: C1.1, C2.1, C3.1, C4.1, C5.1, C6.1, C7.1, C8.1, C9.1, C10.1, C11.1, C12.1, C13.1, C24.1, C25.1, C32.1, C33.1, C34.1, C35.1, C36.1, C37.1, C38.1, C39.1, C40.1, IN.2, L1.VDD, L2.VDD, L3.VDD, L4.VDD, L5.VDD, L6.VDD, L7.VDD, L8.VDD, L9.VDD, L10.VDD, L11.VDD, L12.VDD, L13.VDD, L14.VDD, L15.VDD, L16.VDD, L17.VDD, L18.VDD, L19.VDD, L20.VDD, L21.VDD, L22.VDD, L23.VDD, L24.VDD, L25.VDD, L26.VDD, L27.VDD, L28.VDD, L29.VDD, L30.VDD, L31.VDD, L32.VDD, L33.VDD, L34.VDD, L35.VDD, L36.VDD, L37.VDD, L38.VDD, L39.VDD, L40.VDD, OUT.2
DIN: IN.3, L1.DIN (DI)
DOUT: L40.DOUT (DO), OUT.3
GND: C1.2, C2.2, C3.2, C4.2, C5.2, C6.2, C7.2, C8.2, C9.2, C10.2, C11.2, C12.2, C13.2, C24.2, C25.2, C32.2, C33.2, C34.2, C35.2, C36.2, C37.2, C38.2, C39.2, C40.2, IN.1, L1.VSS (GND), L2.VSS (GND), L3.VSS (GND), L4.VSS (GND), L5.VSS (GND), L6.VSS (GND), L7.VSS (GND), L8.VSS (GND), L9.VSS (GND), L10.VSS (GND), L11.VSS (GND), L12.VSS (GND), L13.VSS (GND), L14.VSS (GND), L15.VSS (GND), L16.VSS (GND), L17.VSS (GND), L18.VSS (GND), L19.VSS (GND), L20.VSS (GND), L21.VSS (GND), L22.VSS (GND), L23.VSS (GND), L24.VSS (GND), L25.VSS (GND), L26.VSS (GND), L27.VSS (GND), L28.VSS (GND), L29.VSS (GND), L30.VSS (GND), L31.VSS (GND), L32.VSS (GND), L33.VSS (GND), L34.VSS (GND), L35.VSS (GND), L36.VSS (GND), L37.VSS (GND), L38.VSS (GND), L39.VSS (GND), L40.VSS (GND), OUT.1
unnamed: L9.DOUT (DO), L10.DIN (DI)
unnamed: L10.DOUT (DO), L11.DIN (DI)
unnamed: L11.DOUT (DO), L12.DIN (DI)
unnamed: L12.DOUT (DO), L13.DIN (DI)
unnamed: L13.DOUT (DO), L14.DIN (DI)
unnamed: L14.DOUT (DO), L15.DIN (DI)
unnamed: L15.DOUT (DO), L16.DIN (DI)
unnamed: L17.DOUT (DO), L18.DIN (DI)
unnamed: L18.DOUT (DO), L19.DIN (DI)
unnamed: L19.DOUT (DO), L20.DIN (DI)
unnamed: L20.DOUT (DO), L21.DIN (DI)
unnamed: L21.DOUT (DO), L22.DIN (DI)
unnamed: L22.DOUT (DO), L23.DIN (DI)
unnamed: L23.DOUT (DO), L24.DIN (DI)
unnamed: L25.DOUT (DO), L26.DIN (DI)
unnamed: L26.DOUT (DO), L27.DIN (DI)
unnamed: L27.DOUT (DO), L28.DIN (DI)
unnamed: L28.DOUT (DO), L29.DIN (DI)
unnamed: L29.DOUT (DO), L30.DIN (DI)
unnamed: L30.DOUT (DO), L31.DIN (DI)
unnamed: L31.DOUT (DO), L32.DIN (DI)
unnamed: L33.DOUT (DO), L34.DIN (DI)
unnamed: L34.DOUT (DO), L35.DIN (DI)
unnamed: L35.DOUT (DO), L36.DIN (DI)
unnamed: L36.DOUT (DO), L37.DIN (DI)
unnamed: L37.DOUT (DO), L38.DIN (DI)
unnamed: L38.DOUT (DO), L39.DIN (DI)
unnamed: L39.DOUT (DO), L40.DIN (DI)
unnamed: L8.DOUT (DO), L9.DIN (DI)
unnamed: L16.DOUT (DO), L17.DIN (DI)
unnamed: L24.DOUT (DO), L25.DIN (DI)
unnamed: L32.DOUT (DO), L33.DIN (DI)
unnamed: L1.DOUT (DO), L2.DIN (DI)
unnamed: L2.DOUT (DO), L3.DIN (DI)
unnamed: L3.DOUT (DO), L4.DIN (DI)
unnamed: L4.DOUT (DO), L5.DIN (DI)
unnamed: L5.DOUT (DO), L6.DIN (DI)
unnamed: L6.DOUT (DO), L7.DIN (DI)
unnamed: L7.DOUT (DO), L8.DIN (DI)

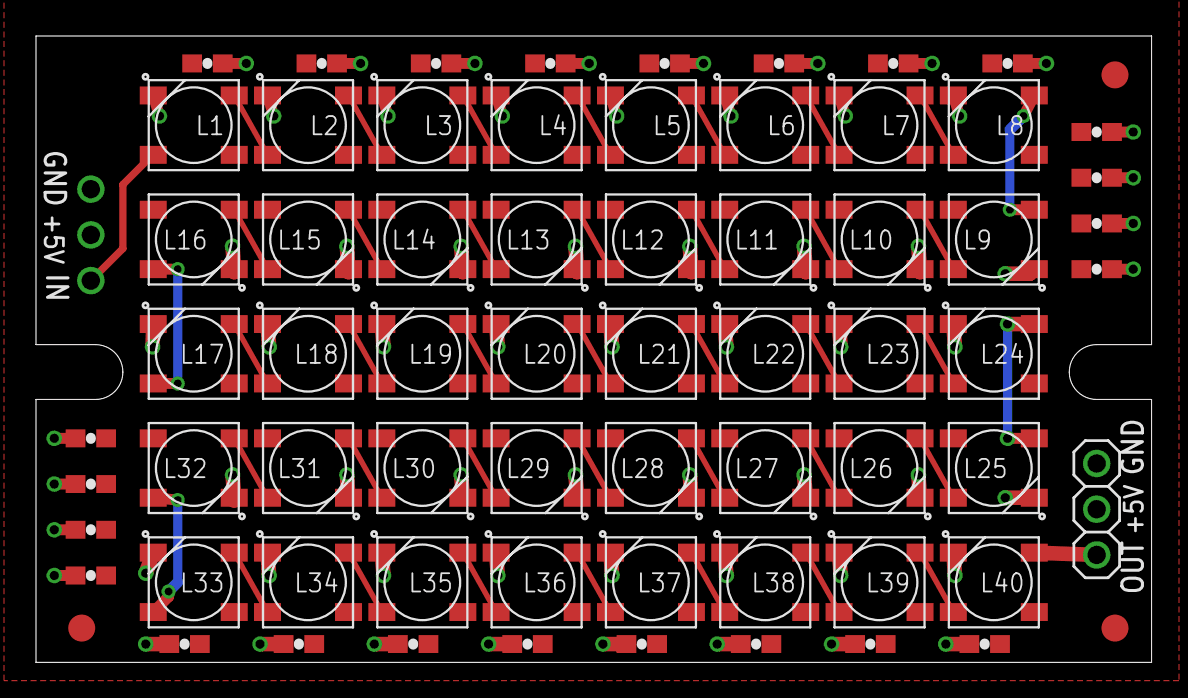
[picture p75: board Logic Engine - Front LED.brd from above]

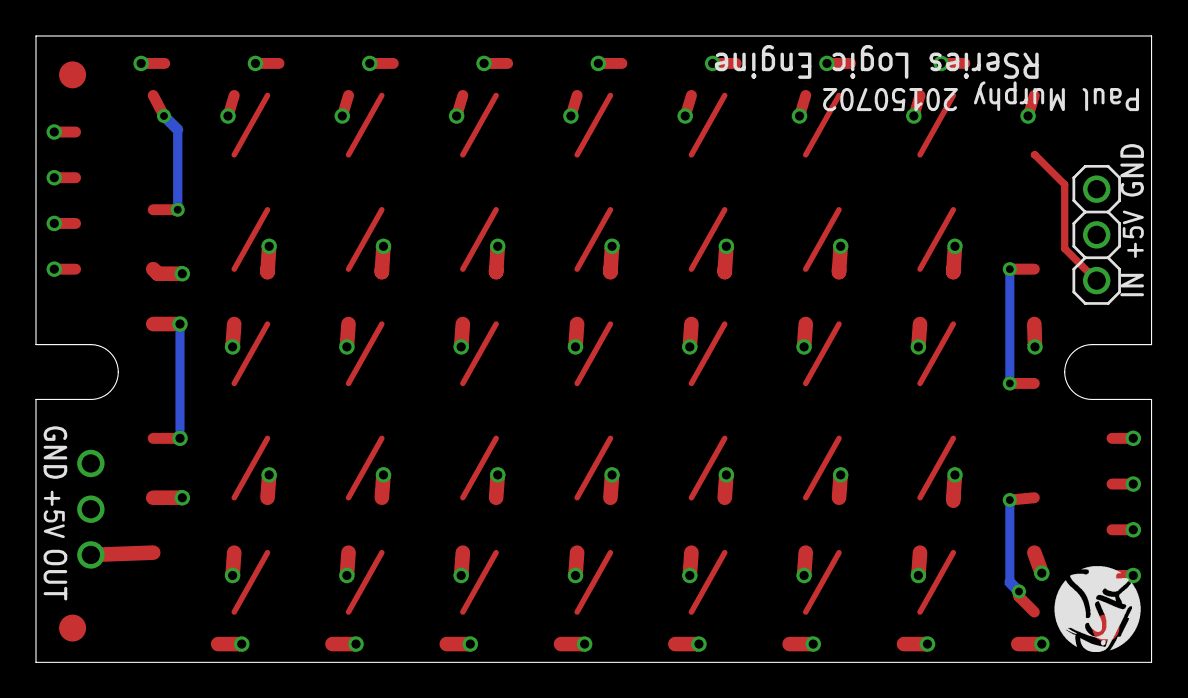
[picture p76: board Logic Engine - Front LED.brd from below]

Board: 2 copper layers, 62.0 x 34.8 mm, 70 parts (2 on the bottom side), 43 nets.

Other parts of the board:
U$2: R2BUILDERS-LOGO
