joymonkey/logicengine/Hardware Designs/Logic Engine - Rear LED.brd

## EAGLE design Hardware Designs/Logic Engine - Rear LED.brd (2015-06-11)

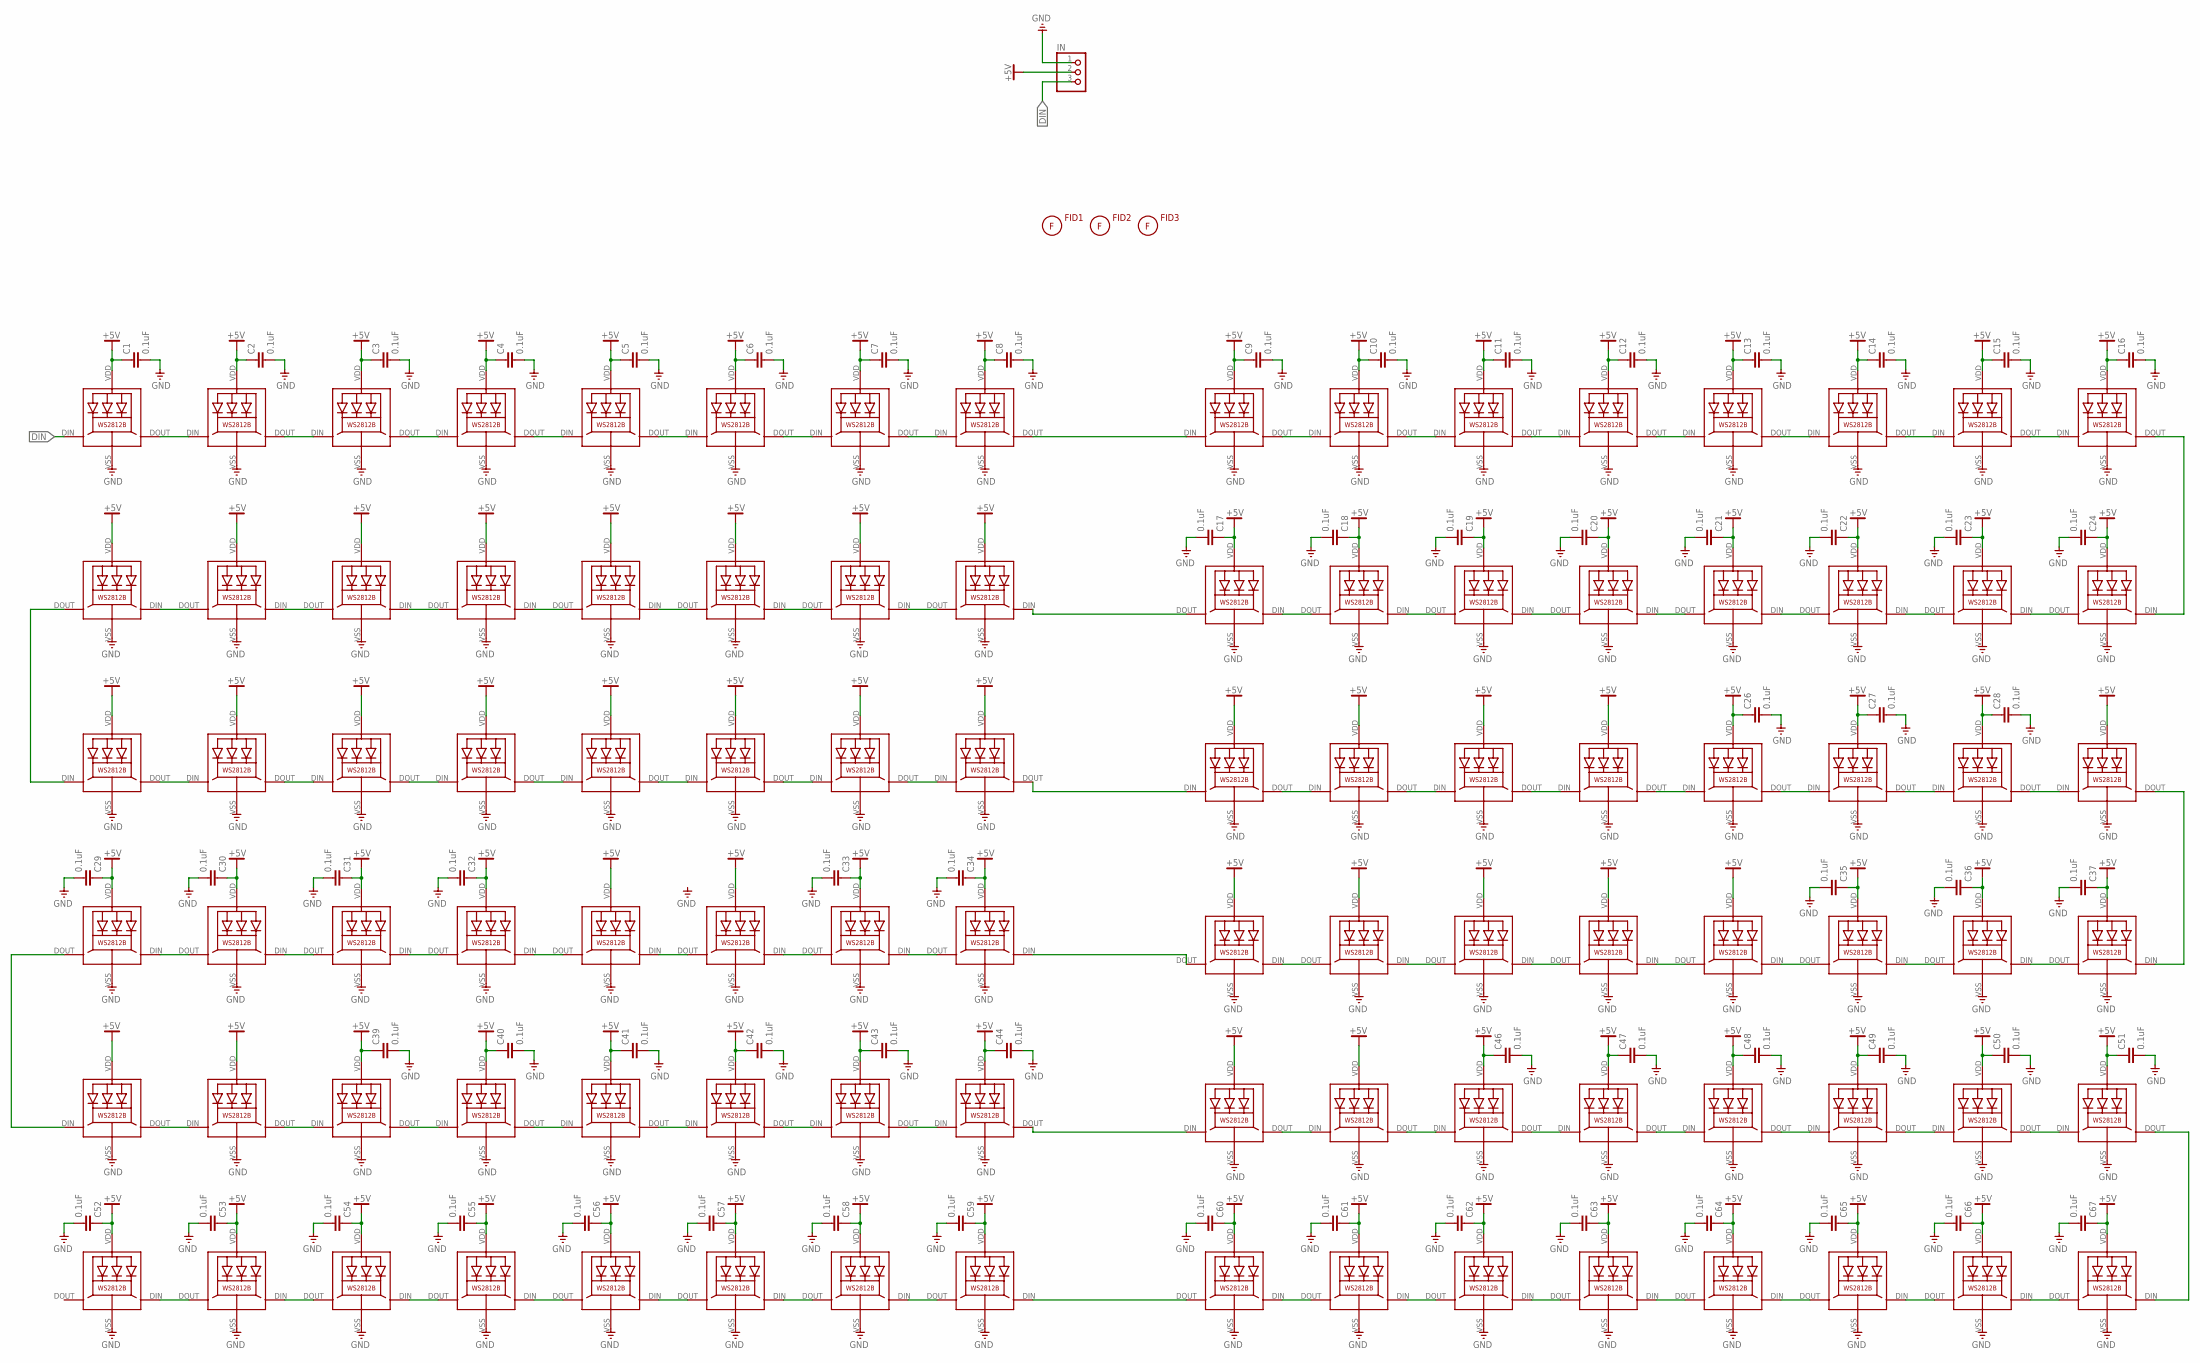
[picture p77: schematic Logic Engine - Rear LED.sch]

Parts:
C1, C2, C3, C4, C5, C6, C7, C8, C9, C10, C11, C12, C13, C14, C15, C16, C17, C18, C19, C20, C21, C22, C23, C24, C26, C27, C28, C29, C30, C31, C32, C33, C34, C35, C36, C37, C39, C40, C41, C42, C43, C44, C46, C47, C48, C49, C50, C51, C52, C53, C54, C55, C56, C57, C58, C59, C60, C61, C62, C63, C64, C65, C66, C67: 0.1uF; 0603-CAP
FID1, FID2, FID3: FIDUCIAL; FIDUCIAL_G15
IN: PINHD-1X3; 1X03
L1, L2, L3, L4, L5, L6, L7, L8, L9, L10, L11, L12, L13, L14, L15, L16, L17, L18, L19, L20, L21, L22, L23, L24, L25, L26, L27, L28, L29, L30, L31, L32, L33, L34, L35, L36, L37, L38, L39, L40, L41, L42, L43, L44, L45, L46, L47, L48, L49, L50, L51, L52, L53, L54, L55, L56, L57, L58, L59, L60, L61, L62, L63, L64, L65, L66, L67, L68, L69, L70, L71, L72, L73, L74, L75, L76, L77, L78, L79, L80, L81, L82, L83, L84, L85, L86, L87, L88, L89, L90, L91, L92, L93, L94, L95, L96: WS2812B

Connections:
+5V: C1.1, C2.1, C3.1, C4.1, C5.1, C6.1, C7.1, C8.1, C9.1, C10.1, C11.1, C12.1, C13.1, C14.1, C15.1, C16.1, C17.1, C18.1, C19.1, C20.1, C21.1, C22.1, C23.1, C24.1, C26.1, C27.1, C28.1, C29.1, C30.1, C31.1, C32.1, C33.1, C34.1, C35.1, C36.1, C37.1, C39.1, C40.1, C41.1, C42.1, C43.1, C44.1, C46.1, C47.1, C48.1, C49.1, C50.1, C51.1, C52.1, C53.1, C54.1, C55.1, C56.1, C57.1, C58.1, C59.1, C60.1, C61.1, C62.1, C63.1, C64.1, C65.1, C66.1, C67.1, IN.2, L1.VDD, L2.VDD, L3.VDD, L4.VDD, L5.VDD, L6.VDD, L7.VDD, L8.VDD, L9.VDD, L10.VDD, L11.VDD, L12.VDD, L13.VDD, L14.VDD, L15.VDD, L16.VDD, L17.VDD, L18.VDD, L19.VDD, L20.VDD, L21.VDD, L22.VDD, L23.VDD, L24.VDD, L25.VDD, L26.VDD, L27.VDD, L28.VDD, L29.VDD, L30.VDD, L31.VDD, L32.VDD, L33.VDD, L34.VDD, L35.VDD, L36.VDD, L37.VDD, L38.VDD, L39.VDD, L40.VDD, L41.VDD, L42.VDD, L43.VDD, L44.VDD, L45.VDD, L46.VDD, L47.VDD, L48.VDD, L49.VDD, L50.VDD, L51.VDD, L52.VDD, L53.VDD, L54.VDD, L55.VDD, L56.VDD, L57.VDD, L58.VDD, L59.VDD, L60.VDD, L61.VDD, L62.VDD, L63.VDD, L64.VDD, L65.VDD, L66.VDD, L67.VDD, L68.VDD, L69.VDD, L70.VDD, L71.VDD, L72.VDD, L73.VDD, L74.VDD, L75.VDD, L76.VDD, L77.VDD, L78.VDD, L79.VDD, L80.VDD, L81.VDD, L82.VDD, L83.VDD, L84.VDD, L85.VDD, L86.VDD, L87.VDD, L88.VDD, L89.VDD, L90.VDD, L91.VDD, L92.VDD, L93.VDD, L94.VDD, L95.VDD, L96.VDD
DIN: IN.3, L1.DIN (DI)
GND: C1.2, C2.2, C3.2, C4.2, C5.2, C6.2, C7.2, C8.2, C9.2, C10.2, C11.2, C12.2, C13.2, C14.2, C15.2, C16.2, C17.2, C18.2, C19.2, C20.2, C21.2, C22.2, C23.2, C24.2, C26.2, C27.2, C28.2, C29.2, C30.2, C31.2, C32.2, C33.2, C34.2, C35.2, C36.2, C37.2, C39.2, C40.2, C41.2, C42.2, C43.2, C44.2, C46.2, C47.2, C48.2, C49.2, C50.2, C51.2, C52.2, C53.2, C54.2, C55.2, C56.2, C57.2, C58.2, C59.2, C60.2, C61.2, C62.2, C63.2, C64.2, C65.2, C66.2, C67.2, IN.1, L1.VSS (GND), L2.VSS (GND), L3.VSS (GND), L4.VSS (GND), L5.VSS (GND), L6.VSS (GND), L7.VSS (GND), L8.VSS (GND), L9.VSS (GND), L10.VSS (GND), L11.VSS (GND), L12.VSS (GND), L13.VSS (GND), L14.VSS (GND), L15.VSS (GND), L16.VSS (GND), L17.VSS (GND), L18.VSS (GND), L19.VSS (GND), L20.VSS (GND), L21.VSS (GND), L22.VSS (GND), L23.VSS (GND), L24.VSS (GND), L25.VSS (GND), L26.VSS (GND), L27.VSS (GND), L28.VSS (GND), L29.VSS (GND), L30.VSS (GND), L31.VSS (GND), L32.VSS (GND), L33.VSS (GND), L34.VSS (GND), L35.VSS (GND), L36.VSS (GND), L37.VSS (GND), L38.VSS (GND), L39.VSS (GND), L40.VSS (GND), L41.VSS (GND), L42.VSS (GND), L43.VSS (GND), L44.VSS (GND), L45.VSS (GND), L46.VSS (GND), L47.VSS (GND), L48.VSS (GND), L49.VSS (GND), L50.VSS (GND), L51.VSS (GND), L52.VSS (GND), L53.VSS (GND), L54.VSS (GND), L55.VSS (GND), L56.VSS (GND), L57.VSS (GND), L58.VSS (GND), L59.VSS (GND), L60.VSS (GND), L61.VSS (GND), L62.VSS (GND), L63.VSS (GND), L64.VSS (GND), L65.VSS (GND), L66.VSS (GND), L67.VSS (GND), L68.VSS (GND), L69.VSS (GND), L70.VSS (GND), L71.VSS (GND), L72.VSS (GND), L73.VSS (GND), L74.VSS (GND), L75.VSS (GND), L76.VSS (GND), L77.VSS (GND), L78.VSS (GND), L79.VSS (GND), L80.VSS (GND), L81.VSS (GND), L82.VSS (GND), L83.VSS (GND), L84.VSS (GND), L85.VSS (GND), L86.VSS (GND), L87.VSS (GND), L88.VSS (GND), L89.VSS (GND), L90.VSS (GND), L91.VSS (GND), L92.VSS (GND), L93.VSS (GND), L94.VSS (GND), L95.VSS (GND), L96.VSS (GND)
unnamed: L23.DIN (DI), L24.DOUT (DO)
unnamed: L22.DIN (DI), L23.DOUT (DO)
unnamed: L21.DIN (DI), L22.DOUT (DO)
unnamed: L20.DIN (DI), L21.DOUT (DO)
unnamed: L19.DIN (DI), L20.DOUT (DO)
unnamed: L18.DIN (DI), L19.DOUT (DO)
unnamed: L17.DIN (DI), L18.DOUT (DO)
unnamed: L33.DOUT (DO), L34.DIN (DI)
unnamed: L34.DOUT (DO), L35.DIN (DI)
unnamed: L35.DOUT (DO), L36.DIN (DI)
unnamed: L36.DOUT (DO), L37.DIN (DI)
unnamed: L37.DOUT (DO), L38.DIN (DI)
unnamed: L38.DOUT (DO), L39.DIN (DI)
unnamed: L39.DOUT (DO), L40.DIN (DI)
unnamed: L55.DIN (DI), L56.DOUT (DO)
unnamed: L54.DIN (DI), L55.DOUT (DO)
unnamed: L53.DIN (DI), L54.DOUT (DO)
unnamed: L52.DIN (DI), L53.DOUT (DO)
unnamed: L51.DIN (DI), L52.DOUT (DO)
unnamed: L50.DIN (DI), L51.DOUT (DO)
unnamed: L49.DIN (DI), L50.DOUT (DO)
unnamed: L65.DOUT (DO), L66.DIN (DI)
unnamed: L66.DOUT (DO), L67.DIN (DI)
unnamed: L67.DOUT (DO), L68.DIN (DI)
unnamed: L68.DOUT (DO), L69.DIN (DI)
unnamed: L69.DOUT (DO), L70.DIN (DI)
unnamed: L70.DOUT (DO), L71.DIN (DI)
unnamed: L71.DOUT (DO), L72.DIN (DI)
unnamed: L24.DIN (DI), L25.DOUT (DO)
unnamed: L17.DOUT (DO), L33.DIN (DI)
unnamed: L40.DOUT (DO), L41.DIN (DI)
unnamed: L48.DOUT (DO), L64.DIN (DI)
unnamed: L87.DIN (DI), L88.DOUT (DO)
unnamed: L86.DIN (DI), L87.DOUT (DO)
unnamed: L85.DIN (DI), L86.DOUT (DO)
unnamed: L84.DIN (DI), L85.DOUT (DO)
unnamed: L83.DIN (DI), L84.DOUT (DO)
unnamed: L82.DIN (DI), L83.DOUT (DO)
unnamed: L81.DIN (DI), L82.DOUT (DO)
unnamed: L1.DOUT (DO), L2.DIN (DI)
unnamed: L2.DOUT (DO), L3.DIN (DI)
unnamed: L3.DOUT (DO), L4.DIN (DI)
unnamed: L4.DOUT (DO), L5.DIN (DI)
unnamed: L5.DOUT (DO), L6.DIN (DI)
unnamed: L6.DOUT (DO), L7.DIN (DI)
unnamed: L7.DOUT (DO), L8.DIN (DI)
unnamed: L56.DIN (DI), L57.DOUT (DO)
unnamed: L9.DOUT (DO), L10.DIN (DI)
unnamed: L10.DOUT (DO), L11.DIN (DI)
unnamed: L11.DOUT (DO), L12.DIN (DI)
unnamed: L12.DOUT (DO), L13.DIN (DI)
unnamed: L13.DOUT (DO), L14.DIN (DI)
unnamed: L14.DOUT (DO), L15.DIN (DI)
unnamed: L15.DOUT (DO), L16.DIN (DI)
unnamed: L31.DIN (DI), L32.DOUT (DO)
unnamed: L30.DIN (DI), L31.DOUT (DO)
unnamed: L29.DIN (DI), L30.DOUT (DO)
unnamed: L28.DIN (DI), L29.DOUT (DO)
unnamed: L27.DIN (DI), L28.DOUT (DO)
unnamed: L26.DIN (DI), L27.DOUT (DO)
unnamed: L25.DIN (DI), L26.DOUT (DO)
unnamed: L41.DOUT (DO), L42.DIN (DI)
unnamed: L42.DOUT (DO), L43.DIN (DI)
unnamed: L43.DOUT (DO), L44.DIN (DI)
unnamed: L44.DOUT (DO), L45.DIN (DI)
unnamed: L45.DOUT (DO), L46.DIN (DI)
unnamed: L46.DOUT (DO), L47.DIN (DI)
unnamed: L47.DOUT (DO), L48.DIN (DI)
unnamed: L63.DIN (DI), L64.DOUT (DO)
unnamed: L62.DIN (DI), L63.DOUT (DO)
unnamed: L61.DIN (DI), L62.DOUT (DO)
unnamed: L60.DIN (DI), L61.DOUT (DO)
unnamed: L59.DIN (DI), L60.DOUT (DO)
unnamed: L58.DIN (DI), L59.DOUT (DO)
unnamed: L57.DIN (DI), L58.DOUT (DO)
unnamed: L73.DOUT (DO), L74.DIN (DI)
unnamed: L74.DOUT (DO), L75.DIN (DI)
unnamed: L75.DOUT (DO), L76.DIN (DI)
unnamed: L76.DOUT (DO), L77.DIN (DI)
unnamed: L77.DOUT (DO), L78.DIN (DI)
unnamed: L78.DOUT (DO), L79.DIN (DI)
unnamed: L79.DOUT (DO), L80.DIN (DI)
unnamed: L95.DIN (DI), L96.DOUT (DO)
unnamed: L94.DIN (DI), L95.DOUT (DO)
unnamed: L93.DIN (DI), L94.DOUT (DO)
unnamed: L92.DIN (DI), L93.DOUT (DO)
unnamed: L91.DIN (DI), L92.DOUT (DO)
unnamed: L90.DIN (DI), L91.DOUT (DO)
unnamed: L89.DIN (DI), L90.DOUT (DO)
unnamed: L8.DOUT (DO), L9.DIN (DI)
unnamed: L16.DOUT (DO), L32.DIN (DI)
unnamed: L49.DOUT (DO), L65.DIN (DI)
unnamed: L72.DOUT (DO), L73.DIN (DI)
unnamed: L80.DOUT (DO), L96.DIN (DI)
unnamed: L88.DIN (DI), L89.DOUT (DO)

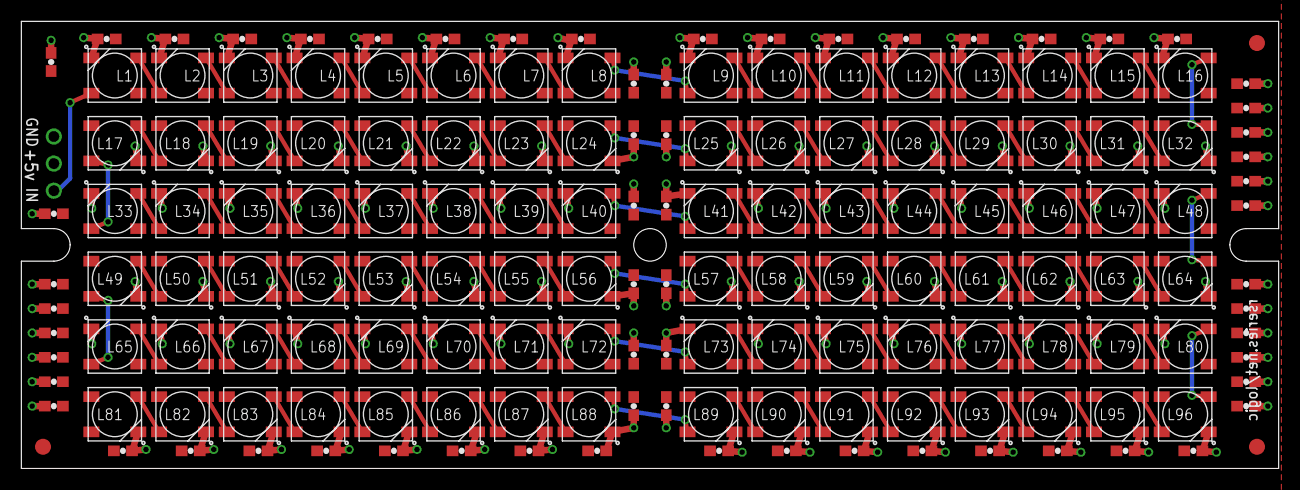
[picture p78: board Logic Engine - Rear LED.brd from above]

Board: 2 copper layers, 117.9 x 41.9 mm, 164 parts (1 on the bottom side), 98 nets.
