joymonkey/logicengine/(commit log)

2015-06-11 initial upload of older Logic Engine stuff
    [Logic Engine - AVR.brd, Logic Engine - AVR.sch, Logic Engine - Front LED.brd, Logic Engine - Front LED.sch]
2015-06-11 added rear LED board (Eagle format)
    [Logic Engine - Rear LED.brd, Logic Engine - Rear LED.sch]
2015-06-11 updated Front LED board to current version
    [Logic Engine - Front LED.brd, Logic Engine - Front LED.sch]
2015-06-24 Updated AVR board to production version
    [Logic Engine - AVR.brd]
2015-10-19 Revised Front LED board slightly
    Front LED board had it's mounting holes & pin headers moved down 0.04
    inches. When mounting in dome this should give a little extra clearance
    (0.08 inches) between the front boards.
    [Logic Engine - Front LED.brd, Logic Engine - Front LED.sch]
2015-10-19 Updated AVR board slightly
    Small revision to AVR board for late 2015 run (first change since these
    boards were first run). Added resistor on LED output, removed reset
    switch, removed 'power' jumper, moved stuff around, routed a little
    smarter (I think), added fancy silkscreen art. Functionality-wise this
    is identical to the previous version.
    [Logic Engine - AVR.brd, Logic Engine - AVR.sch]
2016-12-14 Added new hardware designs (Reactor & LED boards)
    [Logic Engine - Front SK6812.brd, Logic Engine - Front SK6812.sch, Logic Engine - Rear SK6812.sch, Teensy Reactor.brd, Teensy Reactor.sch]
2016-12-20 added Teensy Reactor diagram
2017-01-24 Added PDF assembly guide
2017-06-03 Added basic Teensy Reactor sketch
2017-06-25 small Teensy Reactor sketch update
2018-02-10 added throwback Teeces PSI design files
    [Teeces PSI.brd, Teeces PSI.sch]
2018-04-08 fixed I2C silkscreen error
    [Teensy Reactor.brd]
2018-10-24 Added newer assembly instruction sheet
2018-12-20 fixed microphone function typo (thanks Mimir!)
    [LE_Teensy_Reactor_Jawalite_0.7.ino]
2019-10-20 added Reactor Zero (oops)
    [Reactor_Zero.brd, Reactor_Zero.sch]
2019-12-30 Added Mounty Thing STL and PDF files
    [Reactor to RLD mounty thing.stl]
2020-03-06 updated Teeces PSI board design
    Moved signal routing away from board edge
    [Teeces PSI.brd]
2021-09-29 added new image of WREACTOR32 board
2021-10-17 updated FW, with ability to turn off wifi using button
2022-04-09 Added firmware with less bright default values
    Unless otherwise tweaked by the user, these defaults should cause the whole system to consume less than 500mA at 5V, which should cause fewer problems for people testing via a Micro USB cable.
2022-04-10 added tweaked WReactor32 firmware
    fixed error in firware preventing rear logic adjustment from the board inputs, adjusted default brightness settings to fix current-draw issue when testing via a micro USB cable.
2022-04-26 Create LEngine_20220426.bin
    slight tweak to WReactor32 firmware, to make connections simpler for user of old 96-LED rear logics.
