joymonkey/logicengine/(notices)

Notices in the files:
parts and their libraries:
SparkFun-Aesthetics: Licensing: Creative Commons ShareAlike 4.0 International - https://creativecommons.org/licenses/by-sa/4.0
resistor-array: Copyright (C) 2008, Bob Starr
supply0: Copyright (C) 2007, Bob Starr
